jelkinsjames/chameleon-PCB/PCM1863/README.md

# PCM1863 ADC

The purpose of the ADC in the system is to take analog inputs from control voltages (5V) and convert them into readable I2S digital signals. The digital signals will be processed by the embedded board to be modified by [YASE](https://github.com/klavins/yase) (a synthesizer engine created by Eric Klavins).

The ADC creation has three steps:
1. [Creating the physical ADC board](https://github.com/jelkinsjames/chameleon-PCB/tree/main/PCM1863/board)
2. [Setting up the ADC board and embedded board](https://github.com/jelkinsjames/chameleon-PCB/tree/main/PCM1863/setup)
3. [Using the ADC with the embedded board](https://github.com/jelkinsjames/chameleon-PCB/tree/main/PCM1863/usage)

We will be using the PCM1863 chip by TI for our ADC. The [PCM1863](https://www.ti.com/product/PCM1863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) is an audio-controlled analog-to-digital (ADC) converter. The chip is 110dB 2-channel software controlled. The chip is made by Texas Instruments (TI), and its datasheet is available here: [PCM1863 Datasheet](https://www.ti.com/lit/ds/symlink/pcm1861-q1.pdf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). The chip is a TSSOP (DBT) 30 pin package. The chip is hardware and software controllable.

Drivers for the PCM 186x series are available [here](https://e2e.ti.com/support/audio-group/audio/f/audio-forum/773056/faq-linux-drivers-device-drivers-for-aic31xx-dac31xx-aic325x-aic320x-aic326x-aic321x). More driver information can be found on the [TI webpage](https://www.ti.com/product/PCM1863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) for the PCM1863.

The [Ti PCM186X Evaluation Board](https://www.ti.com/lit/ug/slau615/slau615.pdf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) has additional resources on how to design an example board. [PurePath Console 3 (PPC3)](https://www.ti.com/tool/PUREPATHCONSOLE) is a GUI for development of audio chips such as the PCM1863

Here is a block diagram of the chip we are using:

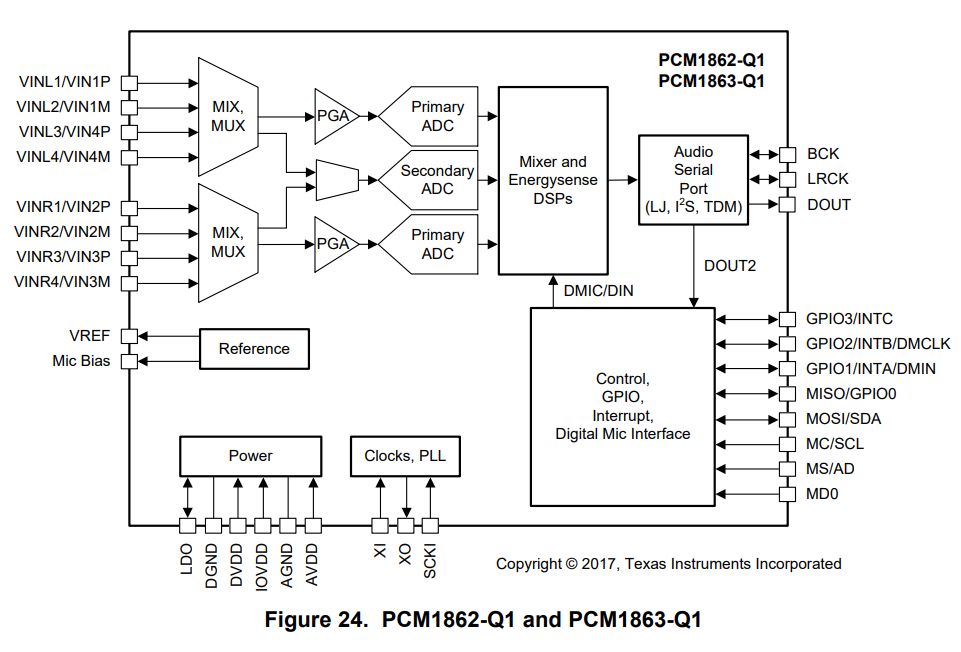
[picture p4: PCM1863/blockdiagram.png]


---
