jelkinsjames/chameleon-PCB/PCM1863/adc_3d.png

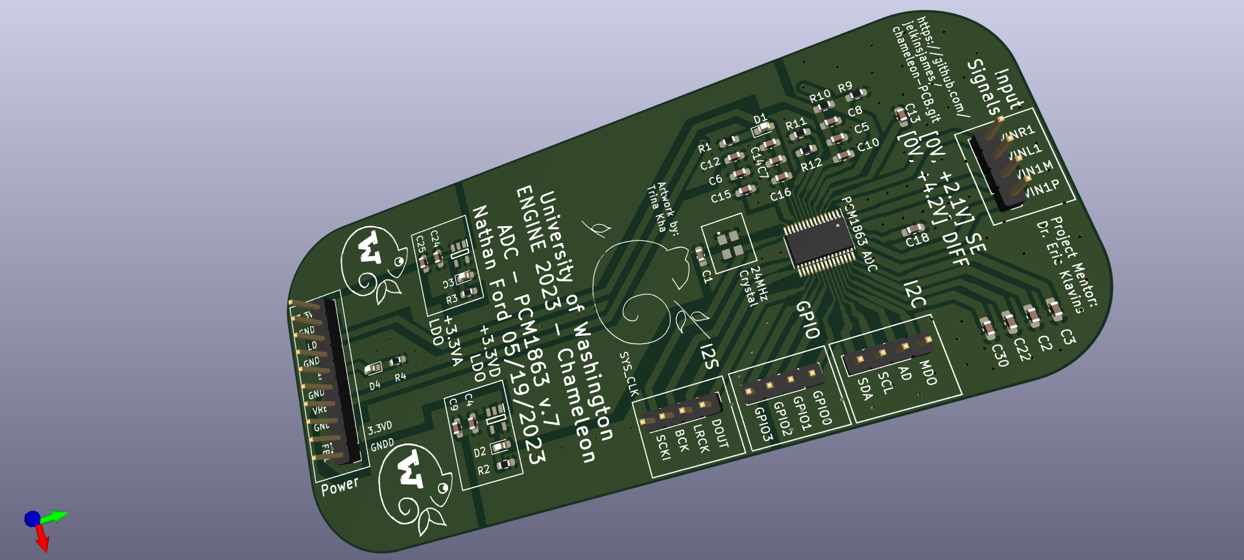
PCM1863/adc_3d.png
