jelkinsjames/chameleon-PCB/PCM1863/docs/assets/images/mastermodeex.png

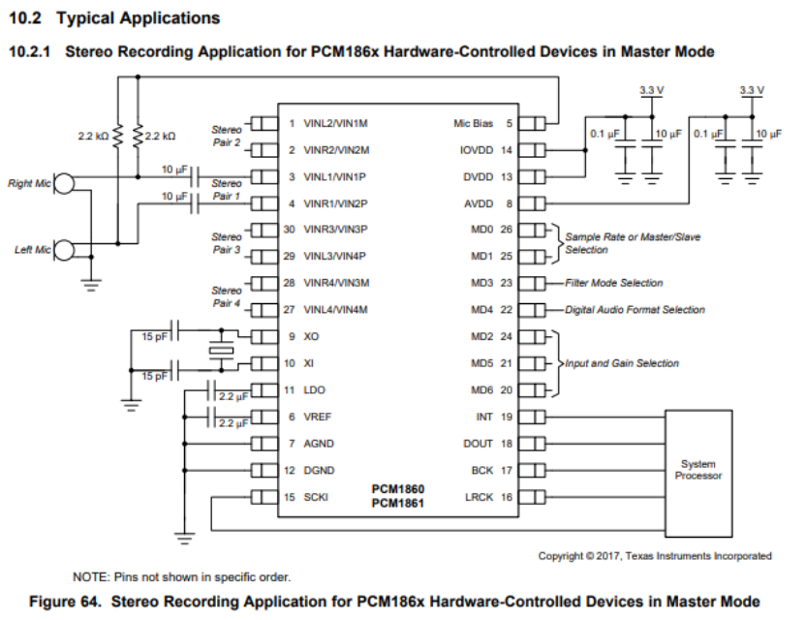
PCM1863/docs/assets/images/mastermodeex.png
