jelkinsjames/chameleon-PCB/PCM1863/docs/assets/images/timingmastermode.png

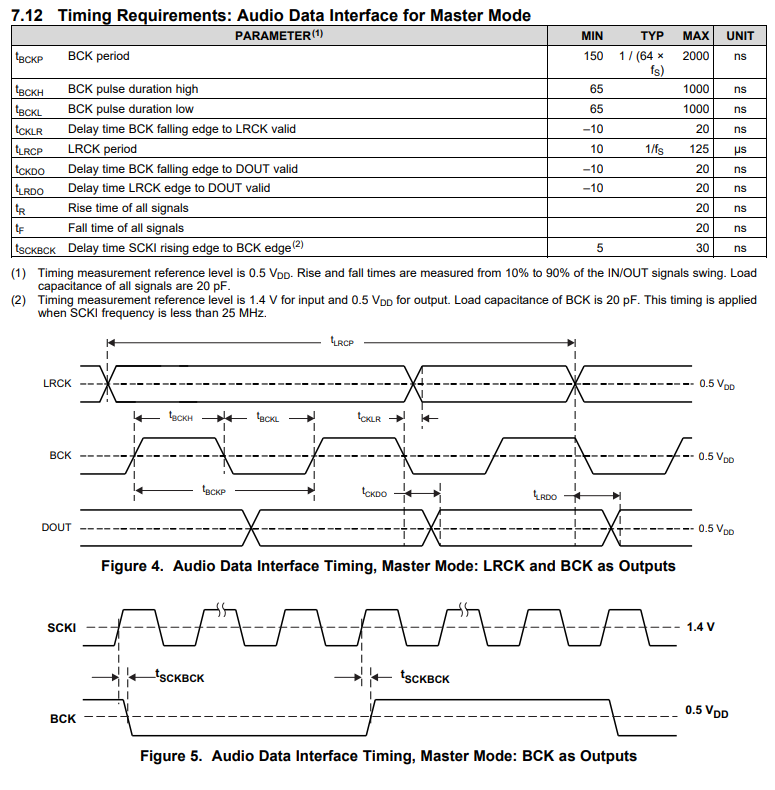
PCM1863/docs/assets/images/timingmastermode.png
