jelkinsjames/chameleon-PCB/STM32tut/manufacturing/STM32tut.csv

Source: | C:\Users\natha\OneDrive - UW\Fourth Year\WINTER\EE 497\KiCad\chameleon-PCB\STM32tut\STM32tut.kicad_sch
Date: | 2/15/2023 1:02:03 PM
Tool: | Eeschema (6.0.5)
Generator: | C:\Program Files\KiCad\6.0\bin\scripting\plugins/bom_csv_grouped_by_value_with_fp.py
Component Count: | 32
Ref | Qnty | Value | Cmp name | Footprint | Description | Vendor
C1, C2, | 2 | 22uF | C | Capacitor_SMD:C_0805_2012Metric_Pad1.18x1.45mm_HandSolder | Unpolarized capacitor
C3, | 1 | 10uF | C | Capacitor_SMD:C_0603_1608Metric_Pad1.08x0.95mm_HandSolder | Unpolarized capacitor
C4, C7, | 2 | 10pF | C | Capacitor_SMD:C_0402_1005Metric_Pad0.74x0.62mm_HandSolder | Unpolarized capacitor
C5, C6, C8, C9, C10, | 5 | 100nF | C | Capacitor_SMD:C_0402_1005Metric_Pad0.74x0.62mm_HandSolder | Unpolarized capacitor
C11, | 1 | 10nF | C | Capacitor_SMD:C_0402_1005Metric_Pad0.74x0.62mm_HandSolder | Unpolarized capacitor
C12, C13, | 2 | 1uF | C | Capacitor_SMD:C_0603_1608Metric_Pad1.08x0.95mm_HandSolder | Unpolarized capacitor
D1, | 1 | RED1.8 | LED | LED_SMD:LED_0603_1608Metric_Pad1.05x0.95mm_HandSolder | Light emitting diode
FB1, | 1 | 120R | FerriteBead | Inductor_SMD:L_0603_1608Metric_Pad1.05x0.95mm_HandSolder | Ferrite bead
H1, H2, H3, H4, | 4 | MountingHole_Pad | MountingHole_Pad | MountingHole:MountingHole_2.2mm_M2_Pad | Mounting Hole with connection
J1, J2, J3, | 3 | Conn_01x04_Male | Conn_01x04_Male | Connector_PinHeader_2.54mm:PinHeader_1x04_P2.54mm_Vertical | Generic connector, single row, 01x04, script generated (kicad-library-utils/schlib/autogen/connector/)
J4, | 1 | USB_B_Micro | USB_B_Micro | Connector_USB:USB_Micro-B_Wuerth_629105150521 | USB Micro Type B connector
R1, R2, R3, R5, | 4 | 1.5k | R | Resistor_SMD:R_0402_1005Metric_Pad0.72x0.64mm_HandSolder | Resistor
R4, | 1 | 10k | R | Resistor_SMD:R_0402_1005Metric_Pad0.72x0.64mm_HandSolder | Resistor
SW1, | 1 | SW_SPDT | SW_SPDT | Button_Switch_SMD:SW_SPDT_PCM12 | Switch, single pole double throw
U1, | 1 | AMS1117-3.3 | AMS1117-3.3 | Package_TO_SOT_SMD:SOT-223-3_TabPin2 | 1A Low Dropout regulator, positive, 3.3V fixed output, SOT-223
U2, | 1 | STM32F103C8T6 | STM32F103C8Tx | Package_QFP:LQFP-48_7x7mm_P0.5mm | ARM Cortex-M3 MCU, 64KB flash, 20KB RAM, 72MHz, 2-3.6V, 37 GPIO, LQFP-48
Y1, | 1 | 16MHz | Crystal_GND24 | Crystal:Crystal_SMD_3225-4Pin_3.2x2.5mm_HandSoldering | Four pin crystal, GND on pins 2 and 4
