jelkinsjames/chameleon-PCB/PCM5242/IC_ADS125H01IRHBT/IC_ADS125H01IRHBT.step

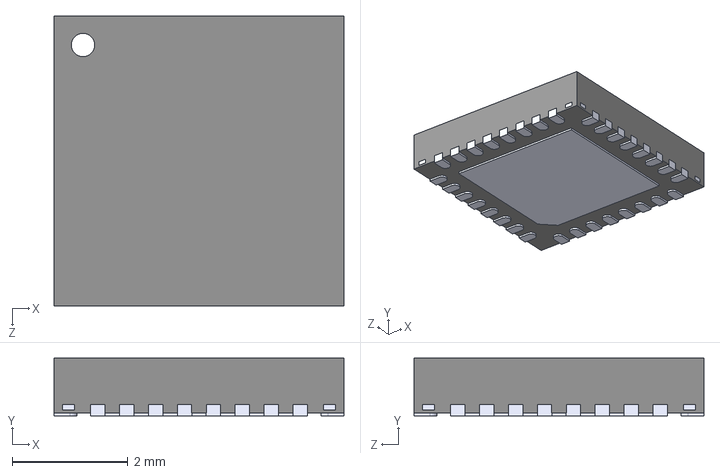
[picture p35: CAD file, 2023-04-08]
PCM5242/IC_ADS125H01IRHBT/IC_ADS125H01IRHBT.step
5.00 x 1.00 x 5.00 mm

STM32tut/629105150521 (rev1).stp
8.00 x 6.60 x 4.52 mm
629105150521_Housing
629105150521_Pin1 x 4
629105150521_Pin2
629105150521_Shielding2
629105150521_Shielding
