jelkinsjames/chameleon-PCB/PCM1863/adc_schematic.pdf

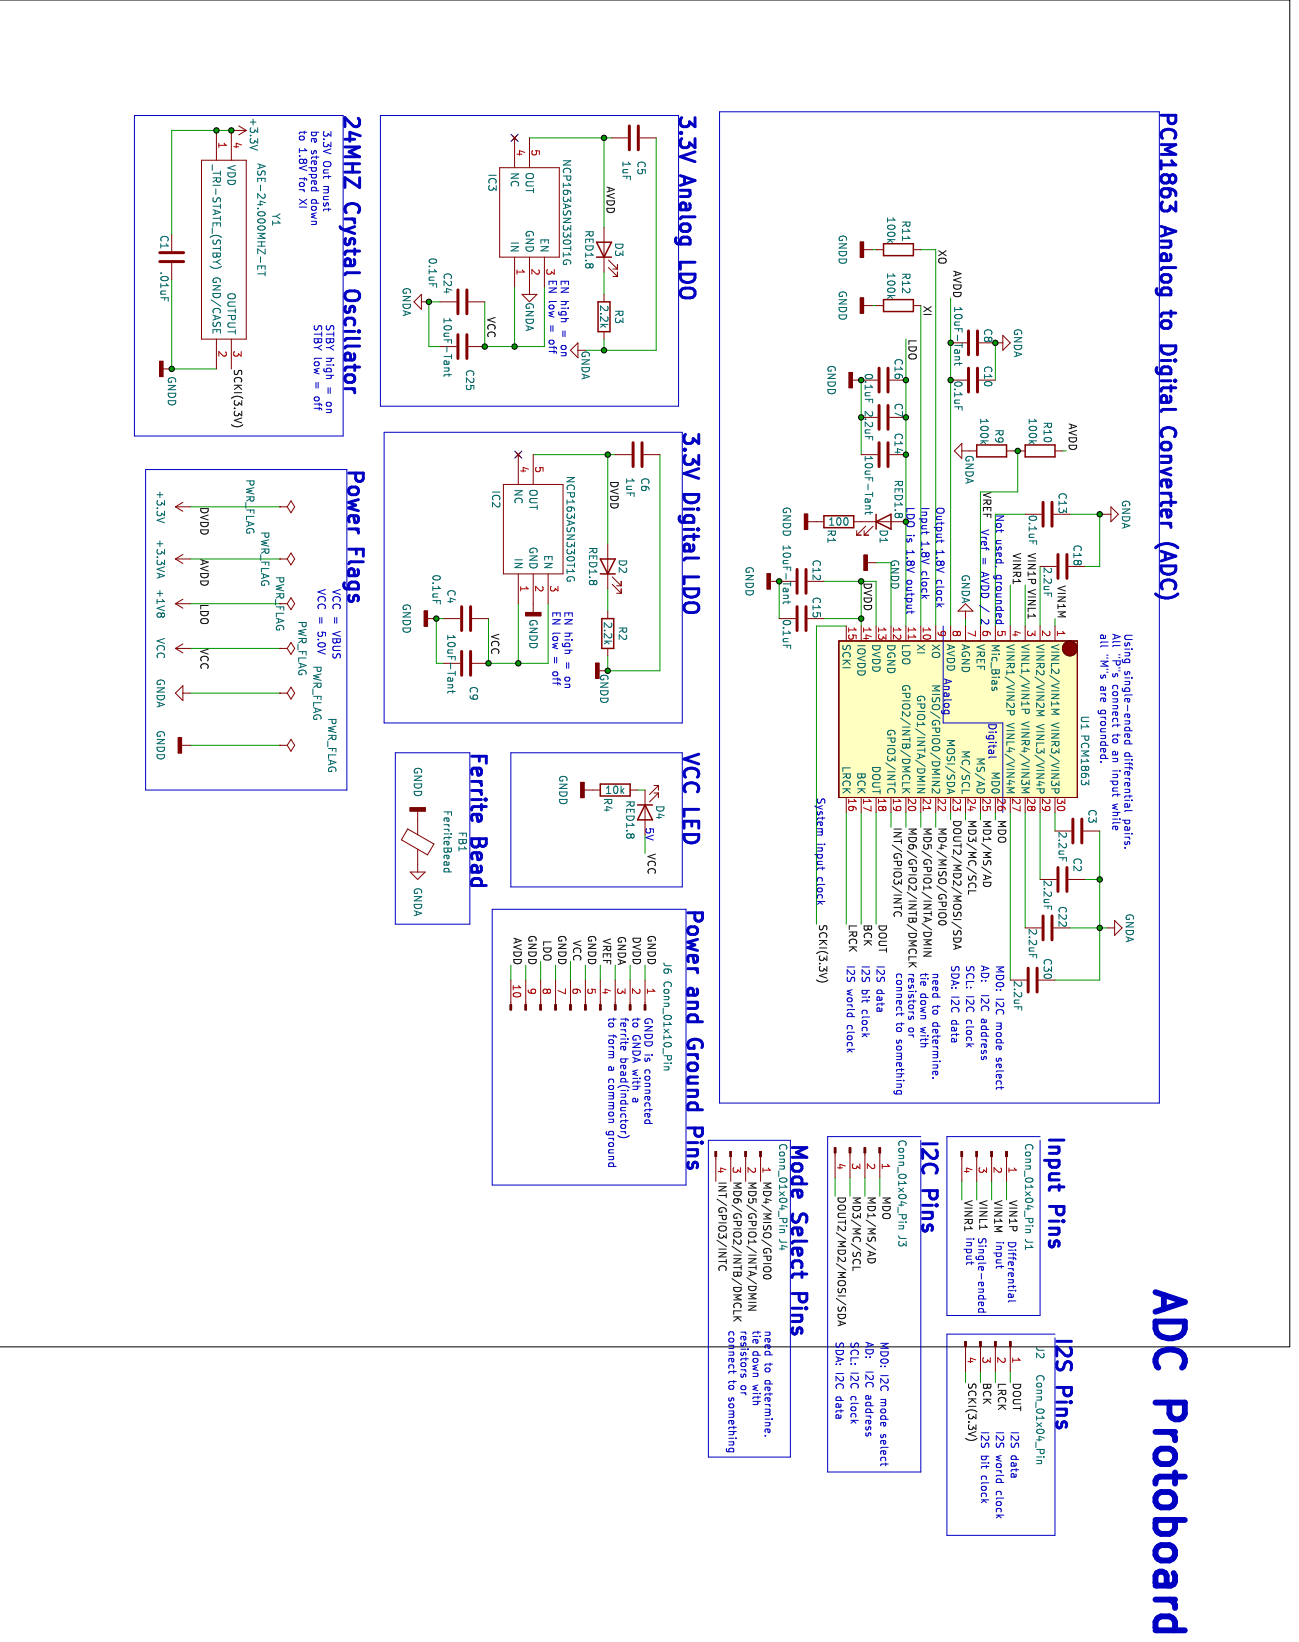
[picture p37: page 1]
