jelkinsjames/chameleon-PCB/PCM1863/adc_pcb.pdf

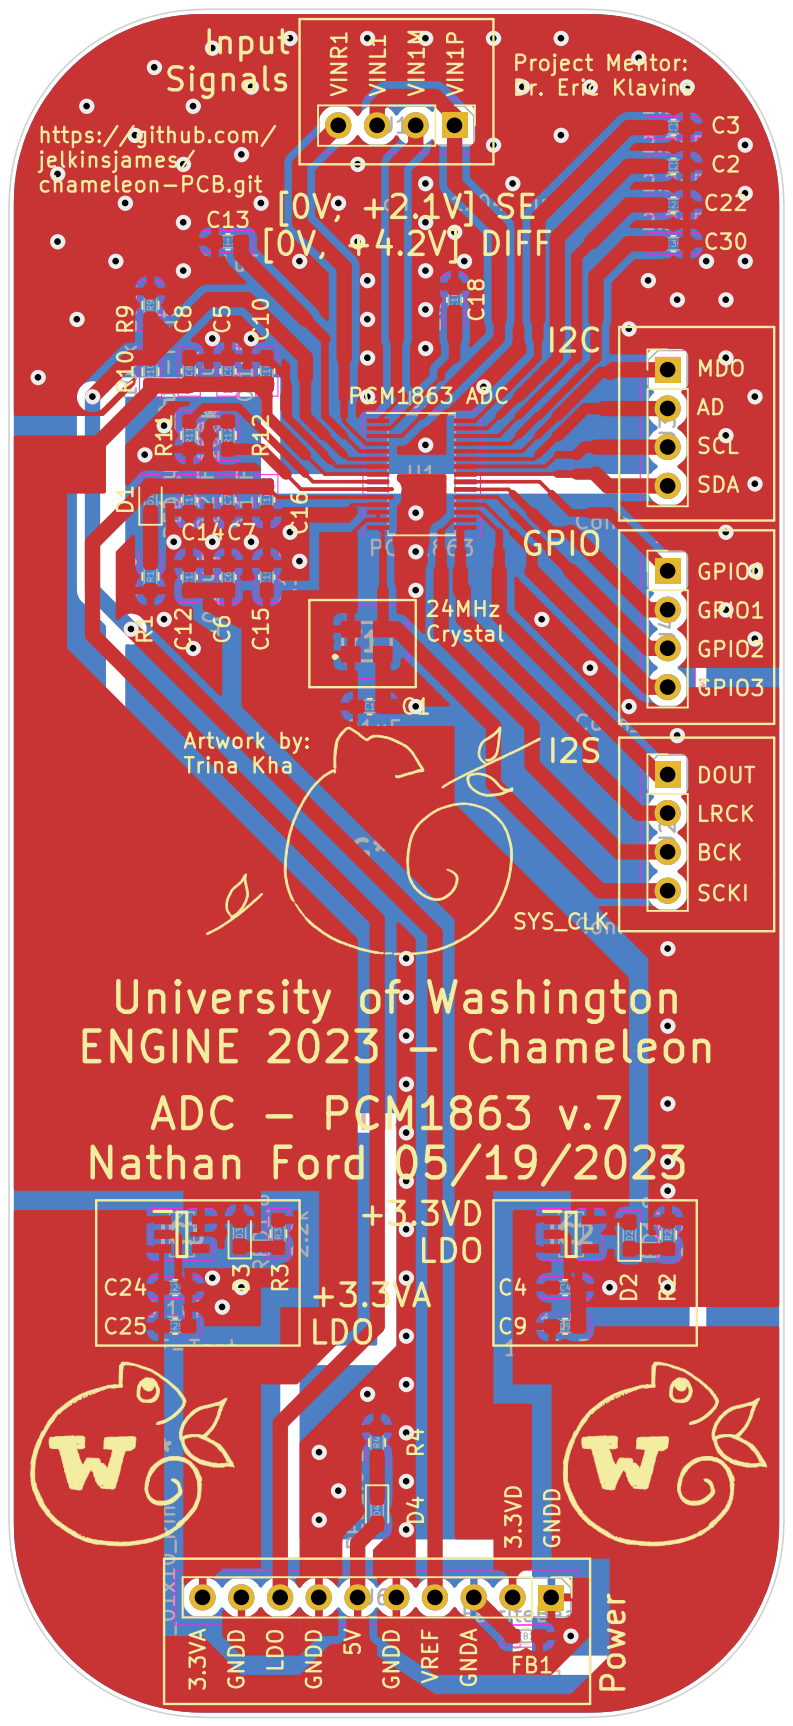
[picture p38: page 1]
