jelkinsjames/chameleon-PCB/IOBoard_ATSAMD21/IOBoard_ATSAMD21.kicad_pcb

## KiCad design IOBoard_ATSAMD21/IOBoard_ATSAMD21.kicad_pcb (2023-05-22)

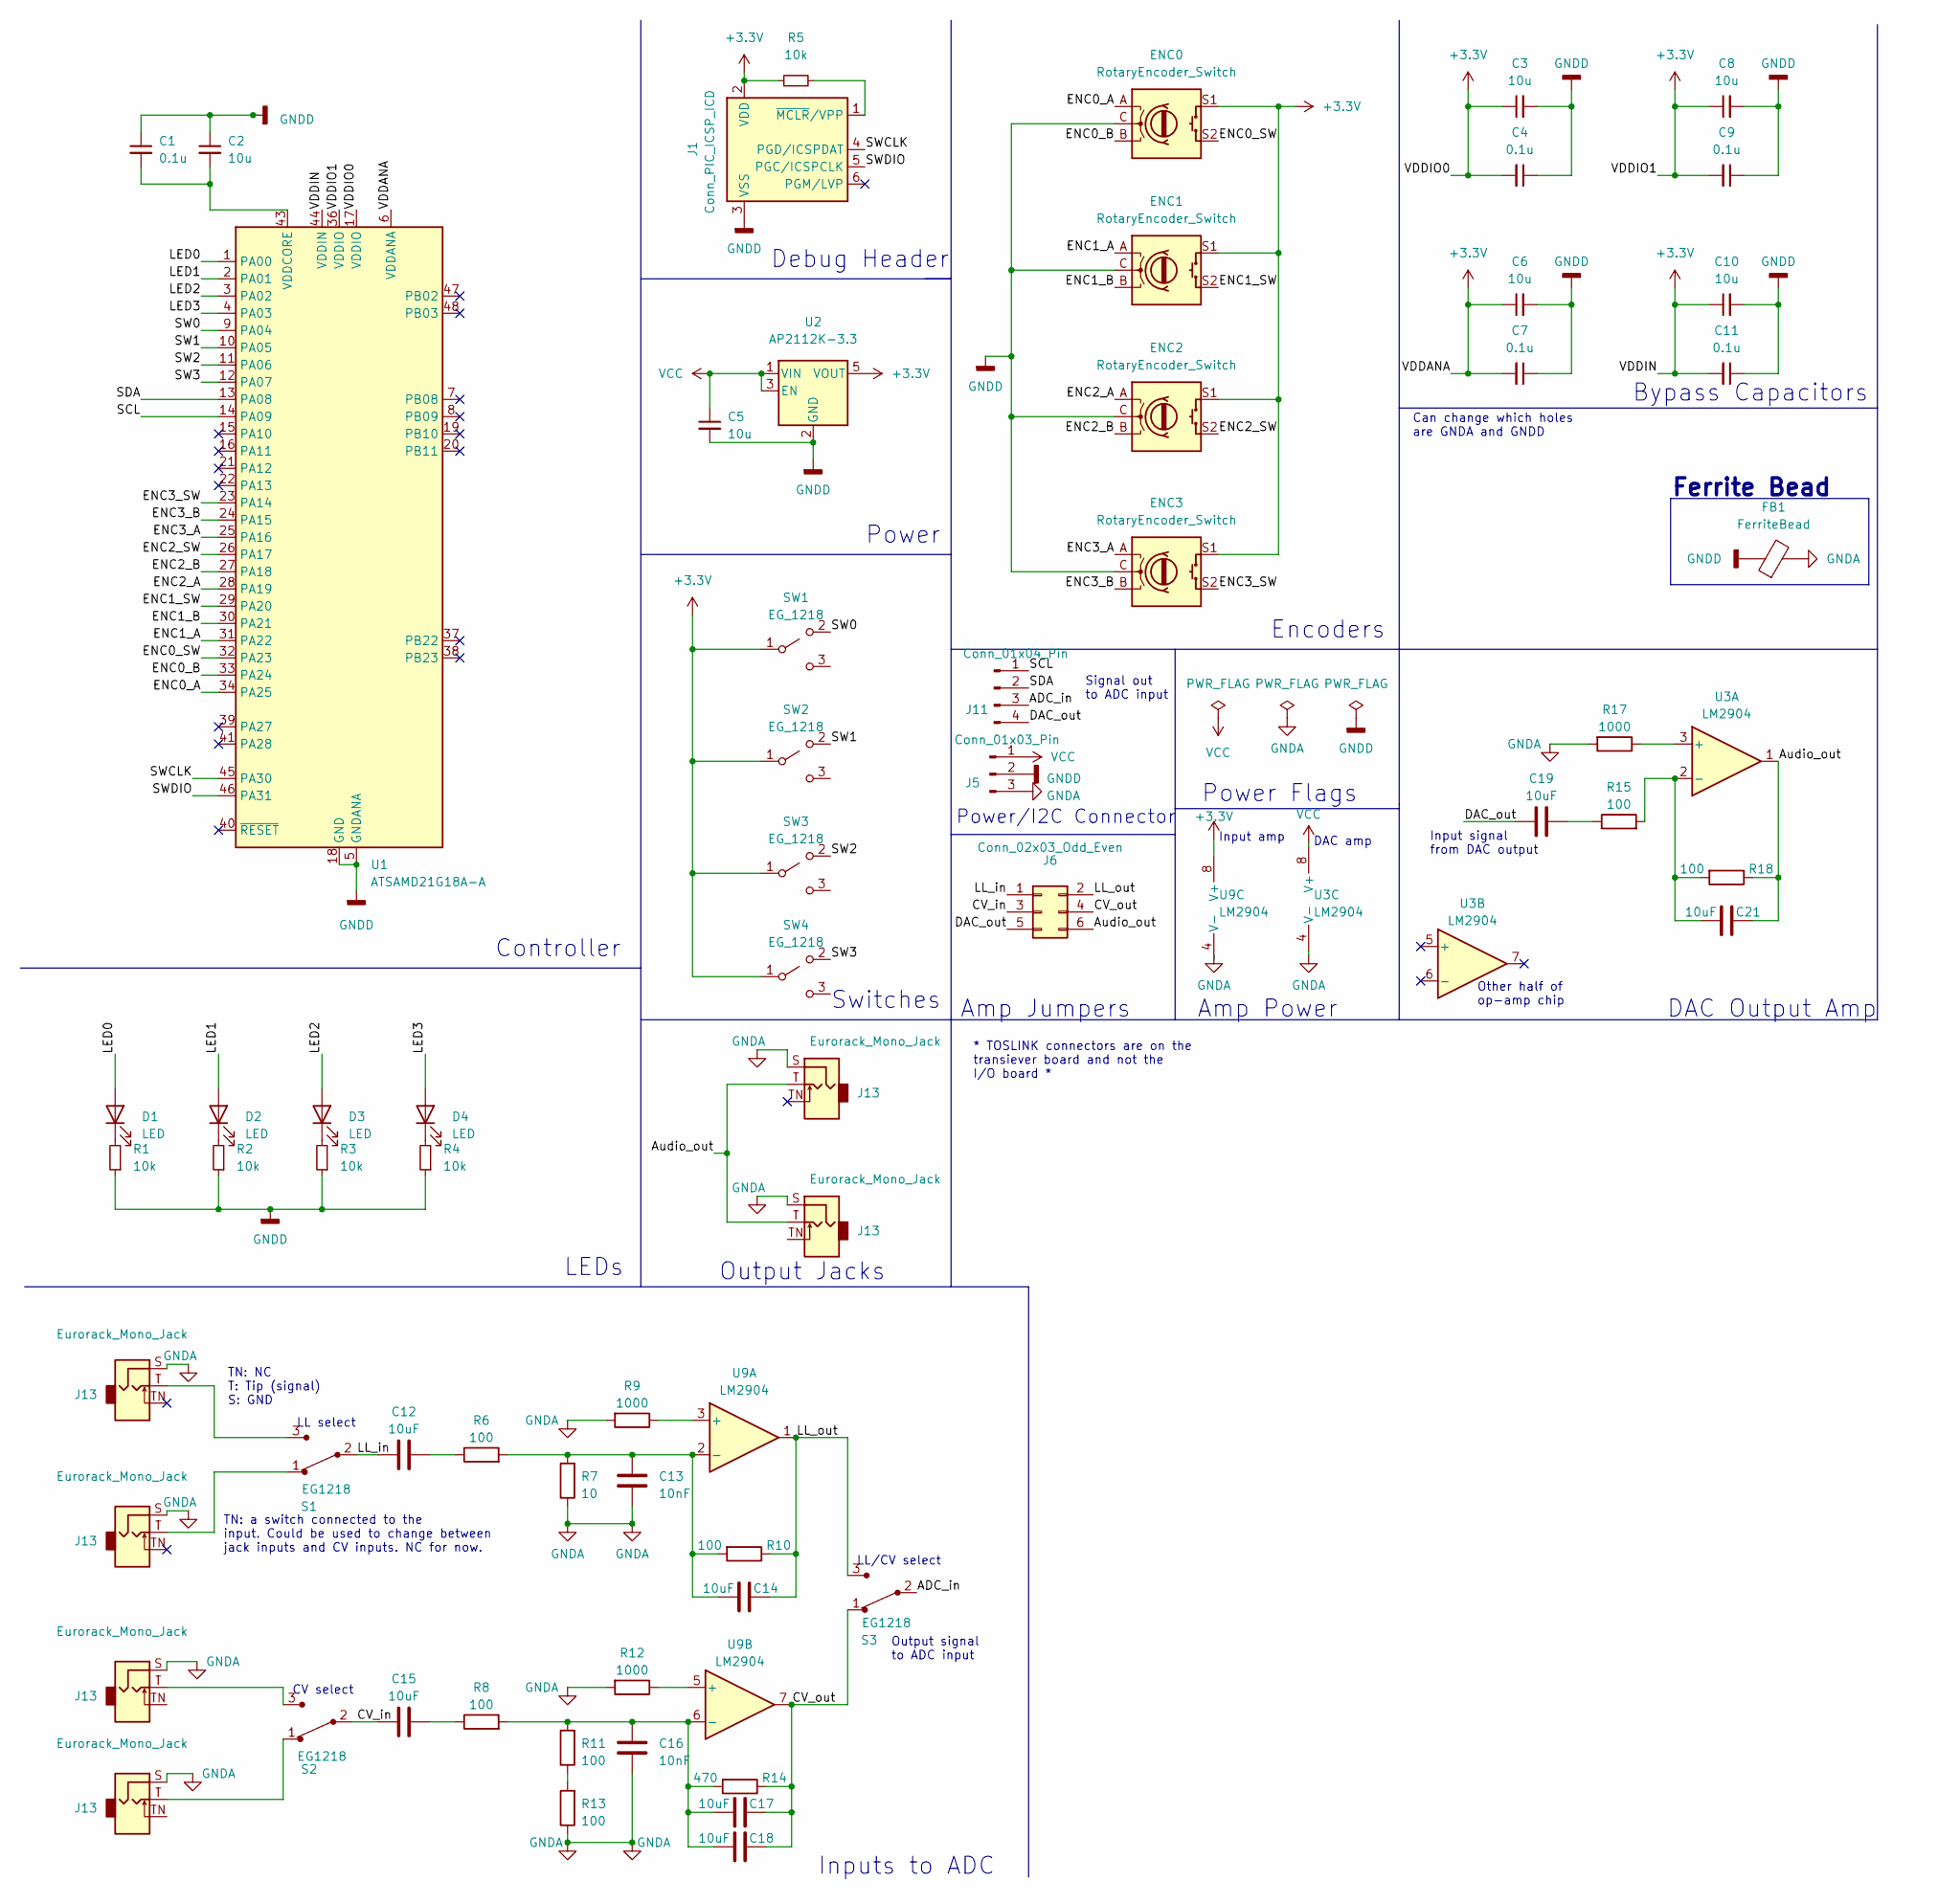
[picture p39: schematic IOBoard_ATSAMD21.kicad_sch, I/O Board]

Parts:
C1, C4, C7, C9, C11: 0.1u; C_0603_1608Metric
C2, C3, C5, C6, C8, C10: 10u; C_0603_1608Metric
C12, C14, C15, C17, C18, C19, C21: 10uF; C_0603_1608Metric
C13, C16: 10nF; C_0603_1608Metric
D1, D2, D3, D4: LED; LED_Rectangular_W5.0mm_H2.0mm
ENC0, ENC1, ENC2, ENC3: RotaryEncoder_Switch; PEC12R-3217F-S0024-ND
FB1: FerriteBead; L_0603_1608Metric_Pad1.05x0.95mm_HandSolder
J1: Conn_PIC_ICSP_ICD; PinHeader_1x06_P2.54mm_Vertical
J5: Conn_01x03_Pin; PinHeader_1x03_P2.54mm_Vertical
J6: Conn_02x03_Odd_Even; PinHeader_2x03_P2.54mm_Vertical
J11: Conn_01x04_Pin; PinHeader_1x04_P2.54mm_Vertical
J13: Eurorack_Mono_Jack; AudioJack_WQP518MA; MPN WQP-WQP518MA
R1, R2, R3, R4, R5: 10k; R_0603_1608Metric
R6, R8, R10, R11, R13, R15, R18: 100; R_0603_1608Metric
R7: 10; R_0603_1608Metric
R9, R12, R17: 1000; R_0603_1608Metric
R14: 470; R_0603_1608Metric
S1, S2, S3: EG1218; EG_1218; MPN EG1218; Digi-Key_PN EG1903-ND
SW1, SW2, SW3, SW4: EG_1218
U1: ATSAMD21G18A-A; TQFP-48_7x7mm_P0.5mm
U2: AP2112K-3.3; SOT-23-5
U3, U9: LM2904; SOIC-8_3.9x4.9mm_P1.27mm

Connections:
+3.3V: C3.1, C4.2, C6.1, C7.2, C8.1, C9.2, C10.1, C11.2, ENC0.S1, ENC1.S1, ENC2.S1, ENC3.S1, J1.2 (VDD), R5.1, SW1.1, SW2.1, SW3.1, SW4.1, U1.6 (VDDANA), U1.17 (VDDIO), U1.36 (VDDIO), U1.44 (VDDIN), U2.5 (VOUT), U9.8 (V+)
/ADC_in: J11.3, S3.2
/Audio_out: C21.1, J6.6, R18.1, U3.1; also elsewhere on the board
/CV_in: C15.1, J6.3, S2.2
/CV_out: C17.1, C18.1, J6.4, R14.1, S3.1, U9.7
/DAC_out: C19.1, J6.5, J11.4
/ENC0_A: ENC0.A, U1.34 (PA25)
/ENC0_B: ENC0.B, U1.33 (PA24)
/ENC0_SW: ENC0.S2, U1.32 (PA23)
/ENC1_A: ENC1.A, U1.31 (PA22)
/ENC1_B: ENC1.B, U1.30 (PA21)
/ENC1_SW: ENC1.S2, U1.29 (PA20)
/ENC2_A: ENC2.A, U1.28 (PA19)
/ENC2_B: ENC2.B, U1.27 (PA18)
/ENC2_SW: ENC2.S2, U1.26 (PA17)
/ENC3_A: ENC3.A, U1.25 (PA16)
/ENC3_B: ENC3.B, U1.24 (PA15)
/ENC3_SW: ENC3.S2, U1.23 (PA14)
/LED0: D1.2 (A), U1.1 (PA00)
/LED1: D2.2 (A), U1.2 (PA01)
/LED2: D3.2 (A), U1.3 (PA02)
/LED3: D4.2 (A), U1.4 (PA03)
/LL_in: C12.1, J6.1, S1.2
/LL_out: C14.1, J6.2, R10.1, S3.3, U9.1
/SCL: J11.1, U1.14 (PA09)
/SDA: J11.2, U1.13 (PA08)
/SW0: SW1.2, U1.9 (PA04)
/SW1: SW2.2, U1.10 (PA05)
/SW2: SW3.2, U1.11 (PA06)
/SW3: SW4.2, U1.12 (PA07)
/SWCLK: J1.4 (PGD/ICSPDAT), U1.45 (PA30)
/SWDIO: J1.5 (PGC/ICSPCLK), U1.46 (PA31)
GNDA: C13.1, C16.1, FB1.2, J5.3, R7.1, R9.2, R12.2, R13.1, R17.2, U3.4 (V-), U9.4 (V-); also elsewhere on the board
GNDD: C1.1, C2.1, C3.2, C4.1, C5.2, C6.2, C7.1, C8.2, C9.1, C10.2, C11.1, ENC0.C, ENC1.C, ENC2.C, ENC3.C, FB1.1, J1.3 (VSS), J5.2, R1.1, R2.1, R3.1, R4.1, U1.5 (GNDANA), U1.18 (GND), U1.35 (GND), U1.42 (GND), U2.2 (GND)
unnamed: C12.2, R6.1
unnamed: C15.2, R8.1
unnamed: C19.2, R15.1
unnamed: D1.1 (K), R1.2
unnamed: D2.1 (K), R2.2
unnamed: D3.1 (K), R3.2
unnamed: D4.1 (K), R4.2
unnamed: J1.1 (~MCLR/VPP), R5.2
unnamed 42: S1.3; also elsewhere on the board
unnamed 43: S1.1; also elsewhere on the board
unnamed 44: S2.3; also elsewhere on the board
unnamed 45: S2.1; also elsewhere on the board
unnamed: R11.1, R13.2
unnamed: C1.2, C2.2, U1.43 (VDDCORE)
unnamed: R17.1, U3.3 (+)
unnamed: C21.2, R15.2, R18.2, U3.2 (-)
unnamed: R9.1, U9.3 (+)
unnamed: C13.2, C14.2, R6.2, R7.2, R10.2, U9.2 (-)
unnamed: R12.1, U9.5 (+)
unnamed: C16.2, C17.2, C18.2, R8.2, R11.2, R14.2, U9.6 (-)
VCC: C5.1, J5.1, U2.1 (VIN), U2.3 (EN), U3.8 (V+)

Notes on the sheet:
LL/CV select
TN: NC T: Tip (signal) S: GND
Input signal from DAC output
Other half of op-amp chip
CV select
LEDs
DAC amp
DAC Output Amp
Debug Header
Encoders
Amp Jumpers
Output Jacks
Switches
Ferrite Bead
Power
Input amp
* TOSLINK connectors are on the transiever board and not the I/O board *
Amp Power
Inputs to ADC
Power/I2C Connector
Signal out to ADC input
TN: a switch connected to the input. Could be used to change between jack inputs and CV inputs. NC for now.
Controller
LL select
Bypass Capacitors
Can change which holes are GNDA and GNDD
Power Flags
Output signal to ADC input

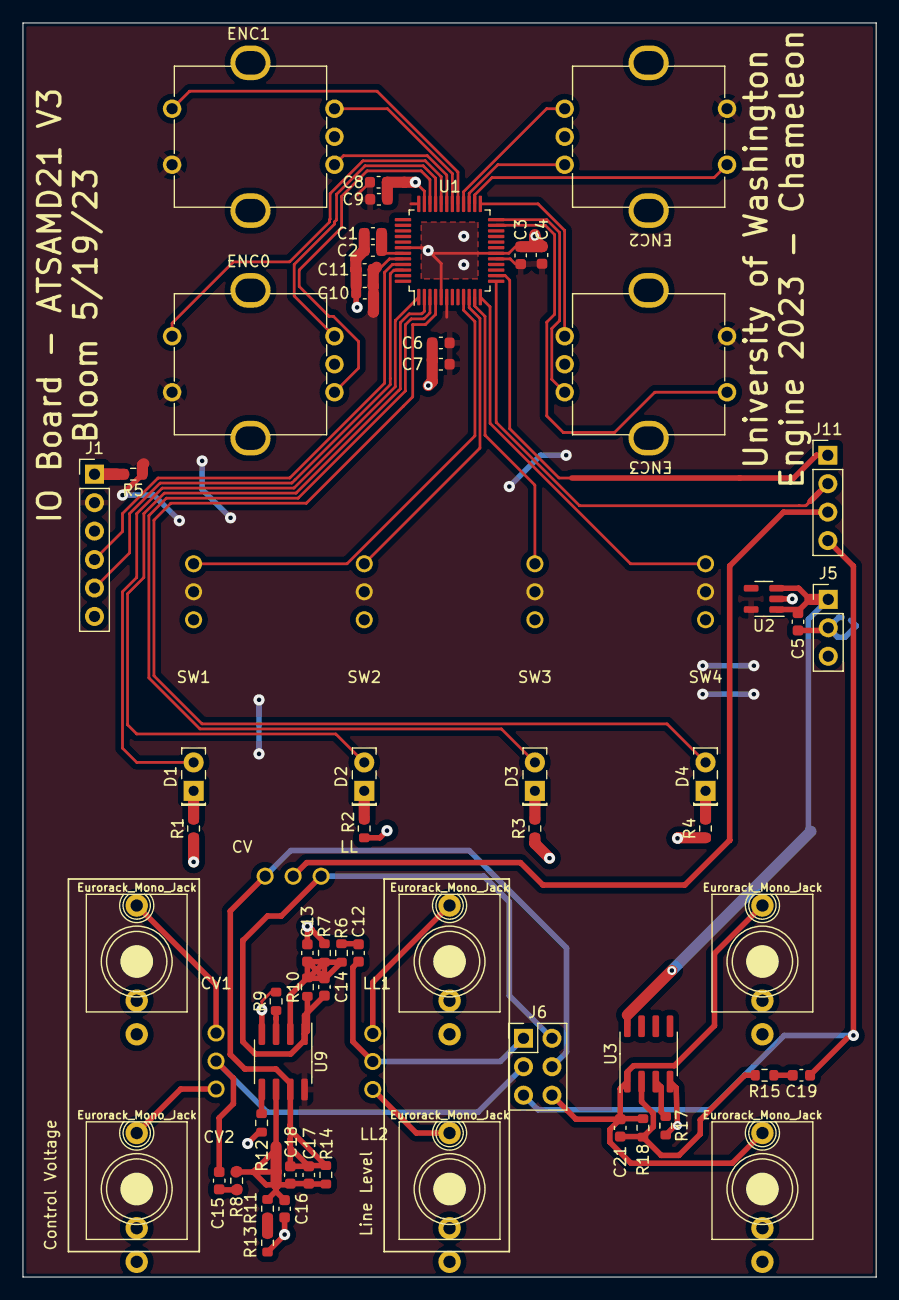
[picture p40: board IOBoard_ATSAMD21.kicad_pcb from above]

Board: 2 copper layers, 76.2 x 112.0 mm, 67 parts (1 on the bottom side), 55 nets.

Other parts of the board:
J2, J3, J4, J7, J8, J10: Eurorack_Mono_Jack; AudioJack_WQP518MA

Their connections:
/Audio_out: J2.T (Tip), J10.T (Tip); also elsewhere on the board
GNDA: J2.S (Sleeve), J3.S (Sleeve), J4.S (Sleeve), J7.S (Sleeve), J8.S (Sleeve), J10.S (Sleeve); also elsewhere on the board
unnamed 42: J3.T (Tip); also elsewhere on the board
unnamed 43: J4.T (Tip); also elsewhere on the board
unnamed 44: J7.T (Tip); also elsewhere on the board
unnamed 45: J8.T (Tip); also elsewhere on the board
