jelkinsjames/chameleon-PCB/PCM1863/PCM1863.kicad_pcb

## KiCad design PCM1863/PCM1863.kicad_pcb (2023-05-21)

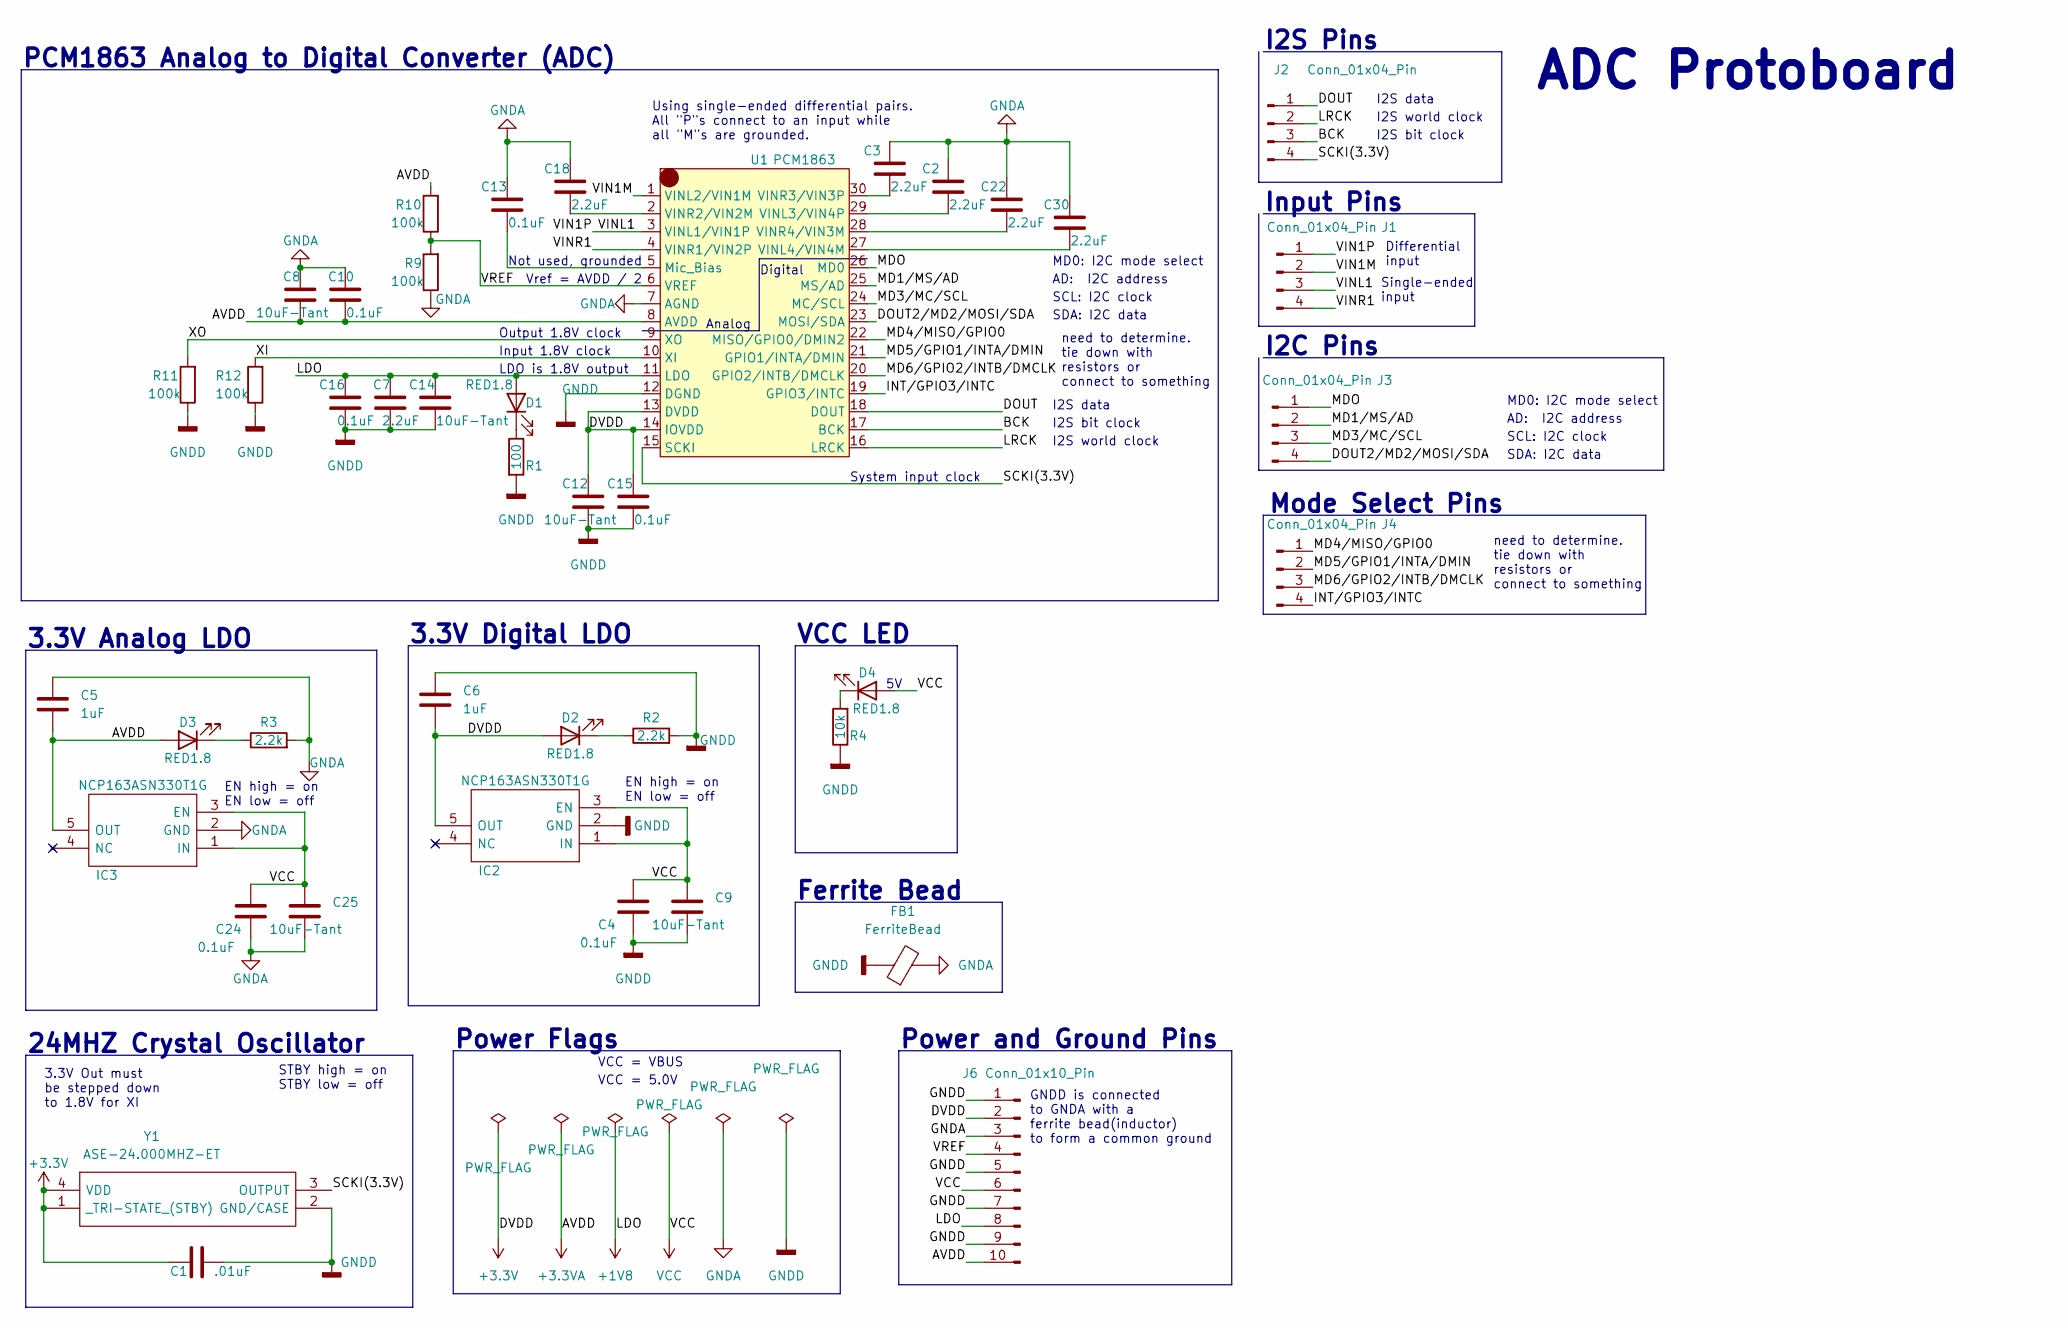
[picture p41: schematic PCM1863.kicad_sch, ADC Protoboard]

Parts:
C1: .01uF; C_0603_1608Metric_Pad1.08x0.95mm_HandSolder
C2, C3, C7, C18, C22, C30: 2.2uF; C_0603_1608Metric_Pad1.08x0.95mm_HandSolder
C4, C10, C13, C15, C16, C24: 0.1uF; C_0603_1608Metric_Pad1.08x0.95mm_HandSolder
C5, C6: 1uF; C_0603_1608Metric_Pad1.08x0.95mm_HandSolder
C8, C9, C12, C14, C25: 10uF-Tant; C_0603_1608Metric_Pad1.08x0.95mm_HandSolder
D1, D2, D3, D4: RED1.8; LED_0603_1608Metric_Pad1.05x0.95mm_HandSolder
FB1: FerriteBead; L_0603_1608Metric_Pad1.05x0.95mm_HandSolder
IC2, IC3: NCP163ASN330T1G; SOT95P280X145-5N; Manufacturer_Part_Number NCP163ASN330T1G; Mouser Part Number 863-NCP163ASN330T1G
J1, J2, J3, J4: Conn_01x04_Pin; PinHeader_1x04_P2.54mm_Vertical
J6: Conn_01x10_Pin; PinHeader_1x10_P2.54mm_Vertical
R1: 100; R_0603_1608Metric_Pad0.98x0.95mm_HandSolder
R2, R3: 2.2k; R_0603_1608Metric_Pad0.98x0.95mm_HandSolder
R4: 10k; R_0603_1608Metric_Pad0.98x0.95mm_HandSolder
R9, R10, R11, R12: 100k; R_0603_1608Metric_Pad0.98x0.95mm_HandSolder
U1: PCM1863; TSSOP-30_4.4x7.8mm_P0.5mm
Y1: ASE-24.000MHZ-ET; ASE24000MHZET; Manufacturer_Part_Number ASE-24.000MHZ-ET; Mouser Part Number 815-ASE24.000MHZET

Connections:
+1V8: C7.1, C14.1, C16.1, D1.2 (A), J6.8, U1.11 (LDO)
+3.3VA: C5.2, C8.2, C10.2, D3.2 (A), IC3.5 (OUT), J6.10, R10.2, U1.8 (AVDD)
+3V3: C1.1, C6.2, C12.1, C15.1, D2.2 (A), IC2.5 (OUT), J6.2, U1.13 (DVDD), U1.14 (IOVDD), Y1.1 (_TRI-STATE_(STBY)), Y1.4 (VDD)
/BCK: J2.3, U1.17 (BCK)
/DOUT: J2.1, U1.18 (DOUT)
/DOUT2/MD2/MOSI/SDA: J3.4, U1.23 (MOSI/SDA)
/INT/GPIO3/INTC: J4.4, U1.19 (GPIO3/INTC)
/LRCK: J2.2, U1.16 (LRCK)
/MD1/MS/AD: J3.2, U1.25 (MS/AD)
/MD3/MC/SCL: J3.3, U1.24 (MC/SCL)
/MD4/MISO/GPIO0: J4.1, U1.22 (MISO/GPIO0/DMIN2)
/MD5/GPIO1/INTA/DMIN: J4.2, U1.21 (GPIO1/INTA/DMIN)
/MD6/GPIO2/INTB/DMCLK: J4.3, U1.20 (GPIO2/INTB/DMCLK)
/MDO: J3.1, U1.26 (MD0)
/SCKI(3.3V): J2.4, U1.15 (SCKI), Y1.3 (OUTPUT)
/VIN1M: J1.2, U1.1 (VINL2/VIN1M)
/VIN1P: J1.1, J1.3, U1.3 (VINL1/VIN1P)
/VINR1: J1.4, U1.4 (VINR1/VIN2P)
/VREF: J6.4, R9.2, R10.1, U1.6 (VREF)
/XI: R12.2, U1.10 (XI)
/XO: R11.2, U1.9 (XO)
GNDA: C2.1, C3.1, C5.1, C8.1, C10.1, C13.1, C18.1, C22.1, C24.2, C25.2, C30.1, FB1.2, IC3.2 (GND), J6.3, R3.2, R9.1, U1.7 (AGND)
GNDD: C1.2, C4.2, C6.1, C7.2, C9.2, C12.2, C14.2, C15.2, C16.2, FB1.1, IC2.2 (GND), J6.1, J6.5, J6.7, J6.9, R1.2, R2.2, R4.1, R11.1, R12.1, U1.12 (DGND), Y1.2 (GND/CASE)
unnamed: D1.1 (K), R1.1
unnamed: D2.1 (K), R2.1
unnamed: D3.1 (K), R3.1
unnamed: D4.1 (K), R4.2
unnamed: C13.2, U1.5 (Mic_Bias)
unnamed: C2.2, U1.29 (VINL3/VIN4P)
unnamed: C30.2, U1.27 (VINL4/VIN4M)
unnamed: C18.2, U1.2 (VINR2/VIN2M)
unnamed: C3.2, U1.30 (VINR3/VIN3P)
unnamed: C22.2, U1.28 (VINR4/VIN3M)
VCC: C4.1, C9.1, C24.1, C25.1, D4.2 (A), IC2.1 (IN), IC2.3 (EN), IC3.1 (IN), IC3.3 (EN), J6.6

Notes on the sheet:
Digital
I2S world clock
Output 1.8V clock
Vref = AVDD / 2
I2S data
MD0: I2C mode select
System input clock
need to determine. tie down with resistors or connect to something
I2C Pins
Power Flags
STBY high = on STBY low = off
SCL: I2C clock
I2S Pins
LDO is 1.8V output
GNDD is connected to GNDA with a ferrite bead(inductor) to form a common ground
I2S bit clock
EN high = on EN low = off
PCM1863 Analog to Digital Converter (ADC)
VCC LED
ADC Protoboard
SDA: I2C data
3.3V Analog LDO
3.3V Out must be stepped down to 1.8V for XI
Input 1.8V clock
3.3V Digital LDO
Single-ended input
Not used, grounded
VCC = VBUS
VCC = 5.0V
Ferrite Bead
AD: I2C address
Mode Select Pins
Input Pins
Power and Ground Pins
Differential input
24MHZ Crystal Oscillator
Analog
Using single-ended differential pairs. All "P"s connect to an input while all "M"s are grounded.

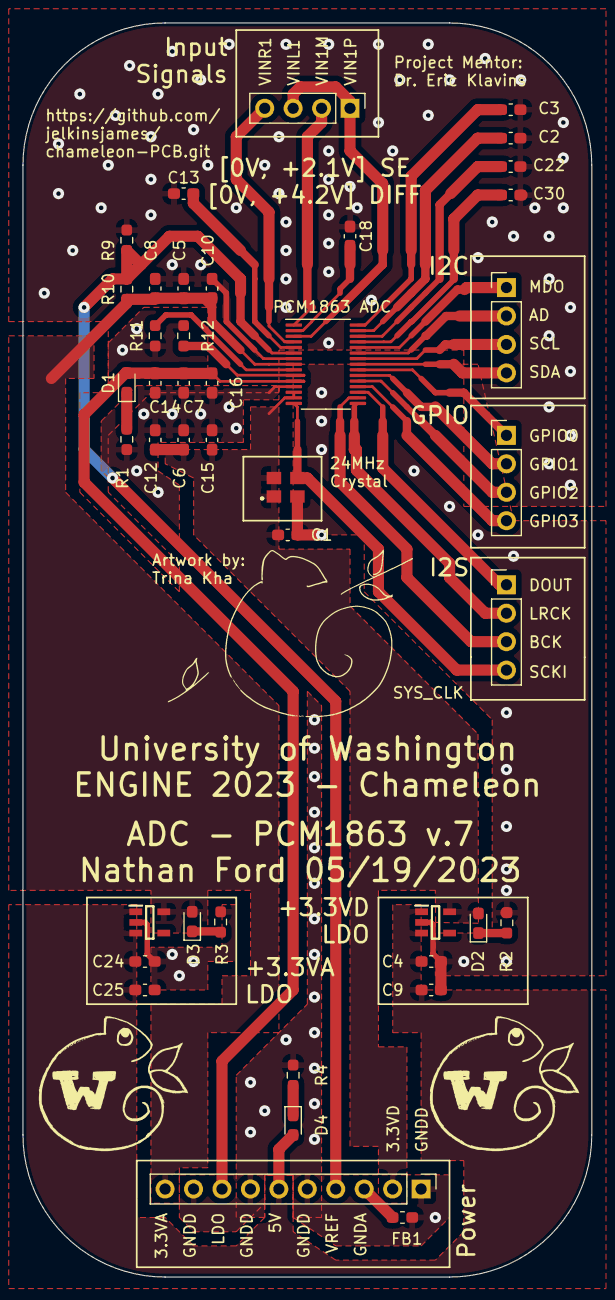
[picture p42: board PCM1863.kicad_pcb from above]

Board: 2 copper layers, 50.8 x 112.0 mm, 42 parts (0 on the bottom side), 34 nets.
