jelkinsjames/chameleon-PCB/PCM5242/restored/PCM5242.kicad_pcb

## KiCad design PCM5242/restored/PCM5242.kicad_pcb (2023-04-27)

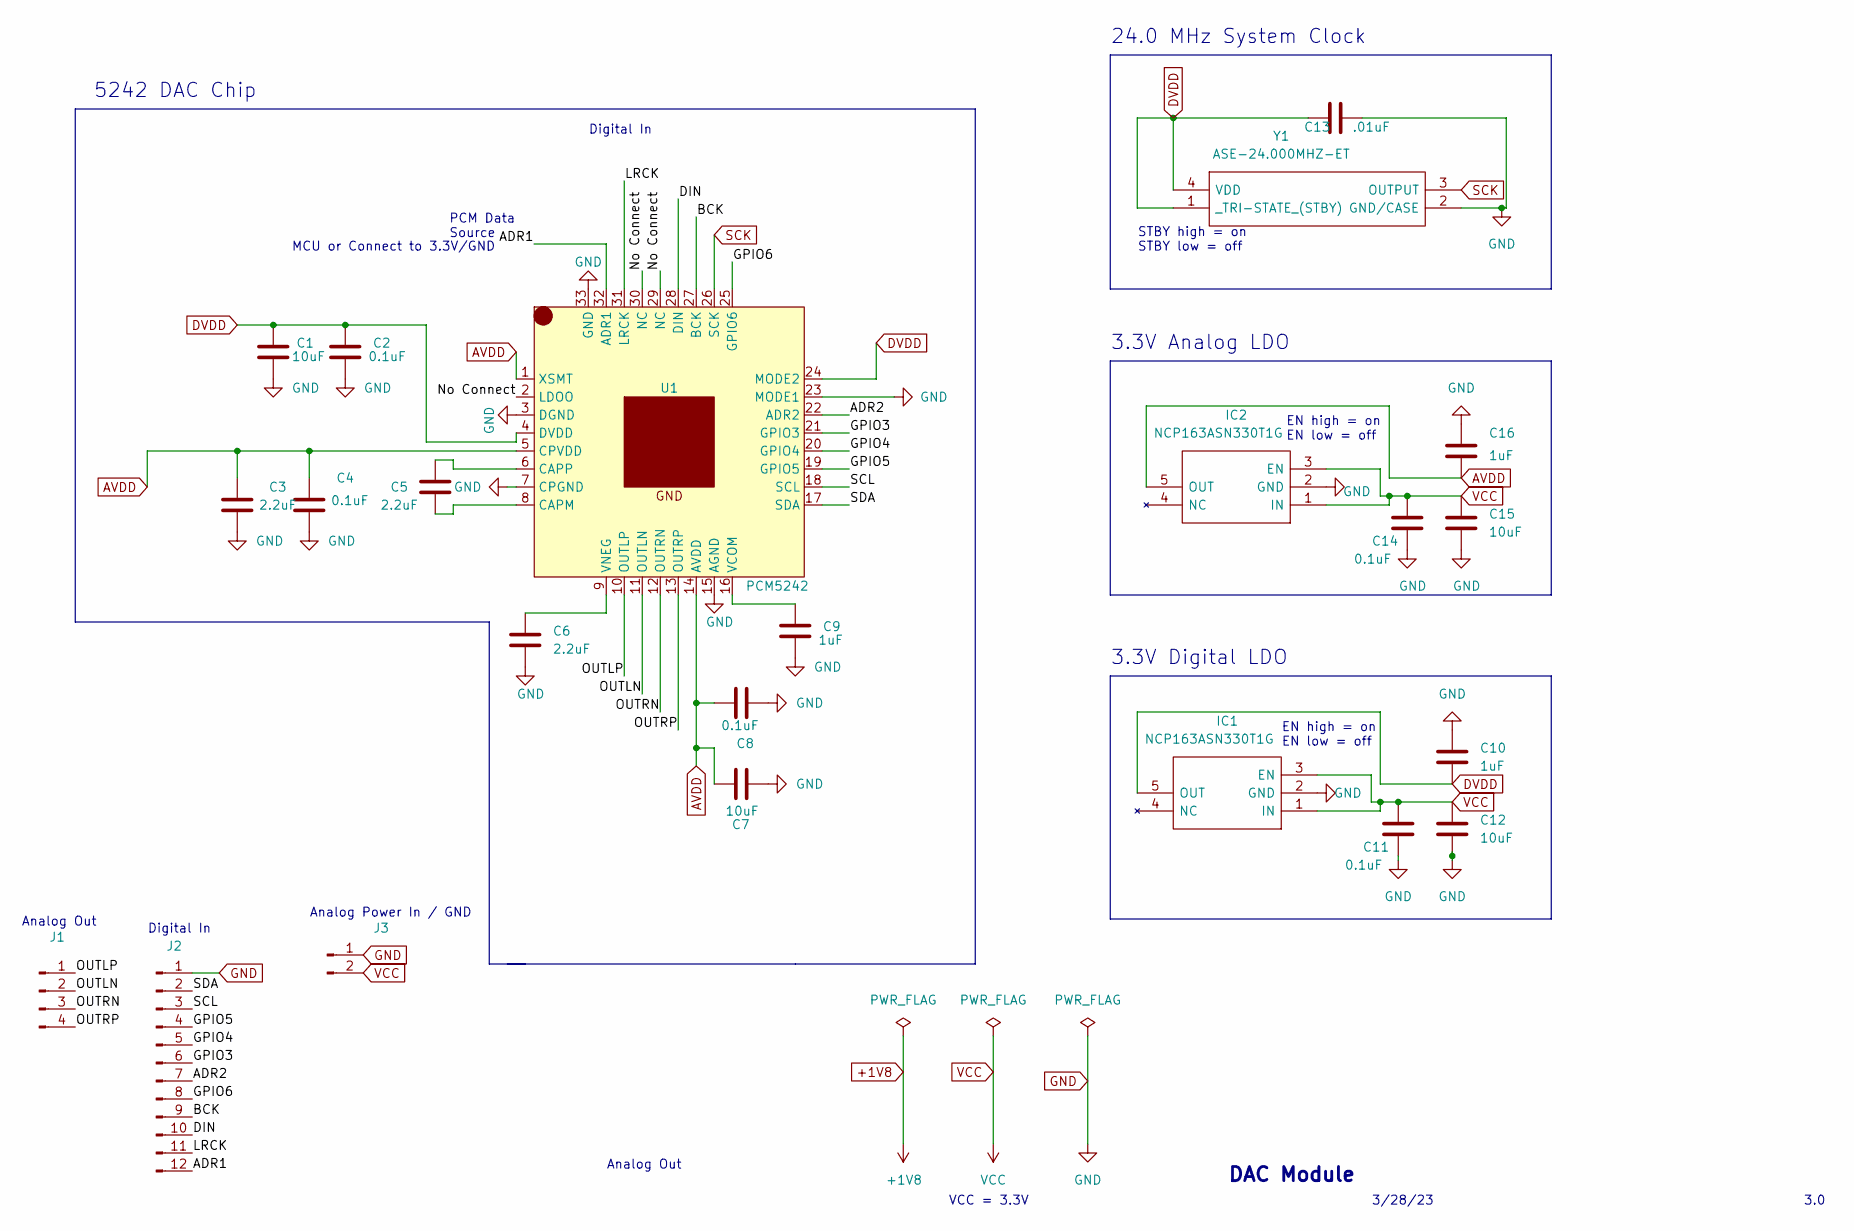
[picture p43: schematic PCM5242.kicad_sch]

Parts:
C1, C7, C12, C15: 10uF; C_0603_1608Metric_Pad1.08x0.95mm_HandSolder
C2, C4, C8, C11, C14: 0.1uF; C_0603_1608Metric_Pad1.08x0.95mm_HandSolder
C3, C5, C6: 2.2uF; C_0603_1608Metric_Pad1.08x0.95mm_HandSolder
C9, C10, C16: 1uF; C_0603_1608Metric_Pad1.08x0.95mm_HandSolder
C13: .01uF; C_0603_1608Metric_Pad1.08x0.95mm_HandSolder
IC1, IC2: NCP163ASN330T1G; SOT95P280X145-5N; Manufacturer_Part_Number NCP163ASN330T1G; Mouser Part Number 863-NCP163ASN330T1G
J1: Conn_01x04_Male; PinHeader_1x04_P2.54mm_Vertical
J2: Conn_01x12_Male; PinHeader_1x12_P2.54mm_Vertical
J3: d; PinHeader_1x02_P2.54mm_Vertical
U1: PCM5242; HVQFN-32-1EP_5x5mm_P0.5mm_EP3.1x3.1mm
Y1: ASE-24.000MHZ-ET; ASE24000MHZET; Manufacturer_Part_Number ASE-24.000MHZ-ET; Mouser Part Number 815-ASE24.000MHZET

Connections:
/ADR1: J2.12, U1.32 (ADR1)
/ADR2: J2.7, U1.22 (ADR2)
/BCK: J2.9, U1.27 (BCK)
/DIN: J2.10, U1.28 (DIN)
/GPIO3: J2.6, U1.21 (GPIO3)
/GPIO4: J2.5, U1.20 (GPIO4)
/GPIO5: J2.4, U1.19 (GPIO5)
/GPIO6: J2.8, U1.25 (GPIO6)
/LRCK: J2.11, U1.31 (LRCK)
/No Connect: U1.2 (LDOO), U1.29 (NC), U1.30 (NC)
/OUTLN: J1.2, U1.11 (OUTLN)
/OUTLP: J1.1, U1.10 (OUTLP)
/OUTRN: J1.3, U1.12 (OUTRN)
/OUTRP: J1.4, U1.13 (OUTRP)
/SCL: J2.3, U1.18 (SCL)
/SDA: J2.2, U1.17 (SDA)
AVDD: C3.1, C4.1, C7.1, C8.1, C16.2, IC2.5 (OUT), U1.1 (XSMT), U1.5 (CPVDD), U1.14 (AVDD)
DVDD: C1.2, C2.1, C10.2, C13.1, IC1.5 (OUT), U1.4 (DVDD), U1.24 (MODE2), Y1.1 (_TRI-STATE_(STBY)), Y1.4 (VDD)
GND: C1.1, C2.2, C3.2, C4.2, C6.2, C7.2, C8.2, C9.2, C10.1, C11.2, C12.2, C13.2, C14.2, C15.2, C16.1, IC1.2 (GND), IC2.2 (GND), J2.1, J3.1, U1.3 (DGND), U1.7 (CPGND), U1.15 (AGND), U1.23 (MODE1), U1.33 (GND), Y1.2 (GND/CASE)
unnamed: C5.1, U1.6 (CAPP)
unnamed: C5.2, U1.8 (CAPM)
unnamed: C6.1, U1.9 (VNEG)
unnamed: C9.1, U1.16 (VCOM)
SCK: U1.26 (SCK), Y1.3 (OUTPUT)
VCC: C11.1, C12.1, C14.1, C15.1, IC1.1 (IN), IC1.3 (EN), IC2.1 (IN), IC2.3 (EN), J3.2

Notes on the sheet:
Analog Out
Digital In
EN high = on EN low = off
3.0
Analog Power In / GND
3.3V Analog LDO
MCU or Connect to 3.3V/GND
24.0 MHz System Clock
STBY high = on STBY low = off
PCM Data Source
DAC Module
VCC = 3.3V
3.3V Digital LDO
Analog Out
Digital In
5242 DAC Chip
3/28/23

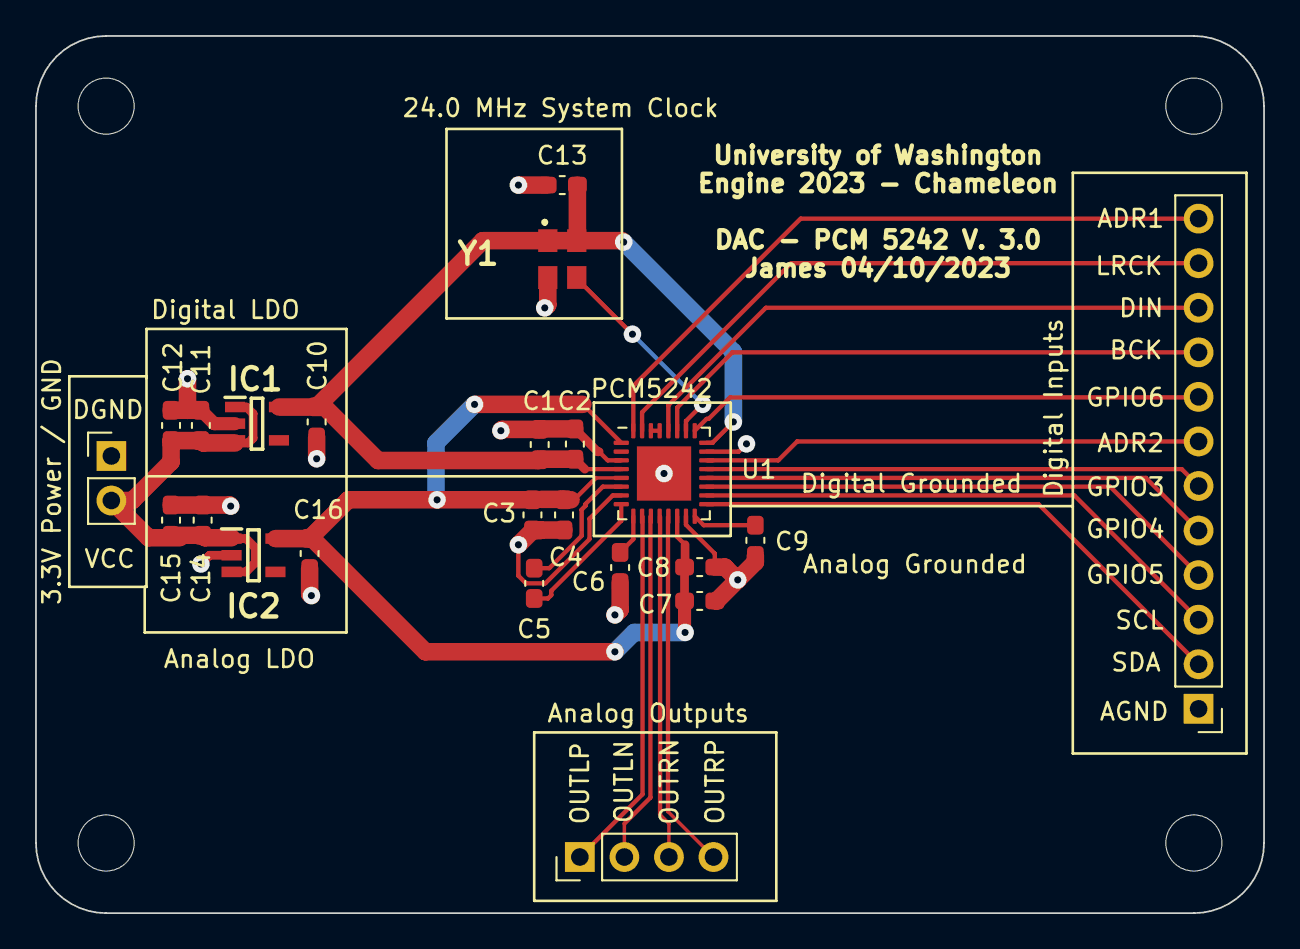
[picture p44: board PCM5242.kicad_pcb from above]

Board: 2 copper layers, 70.0 x 50.0 mm, 23 parts (0 on the bottom side), 25 nets.
