jelkinsjames/chameleon-PCB/DIX/Transmitter.kicad_pcb

## KiCad design DIX/Transmitter.kicad_pcb (2023-04-03)

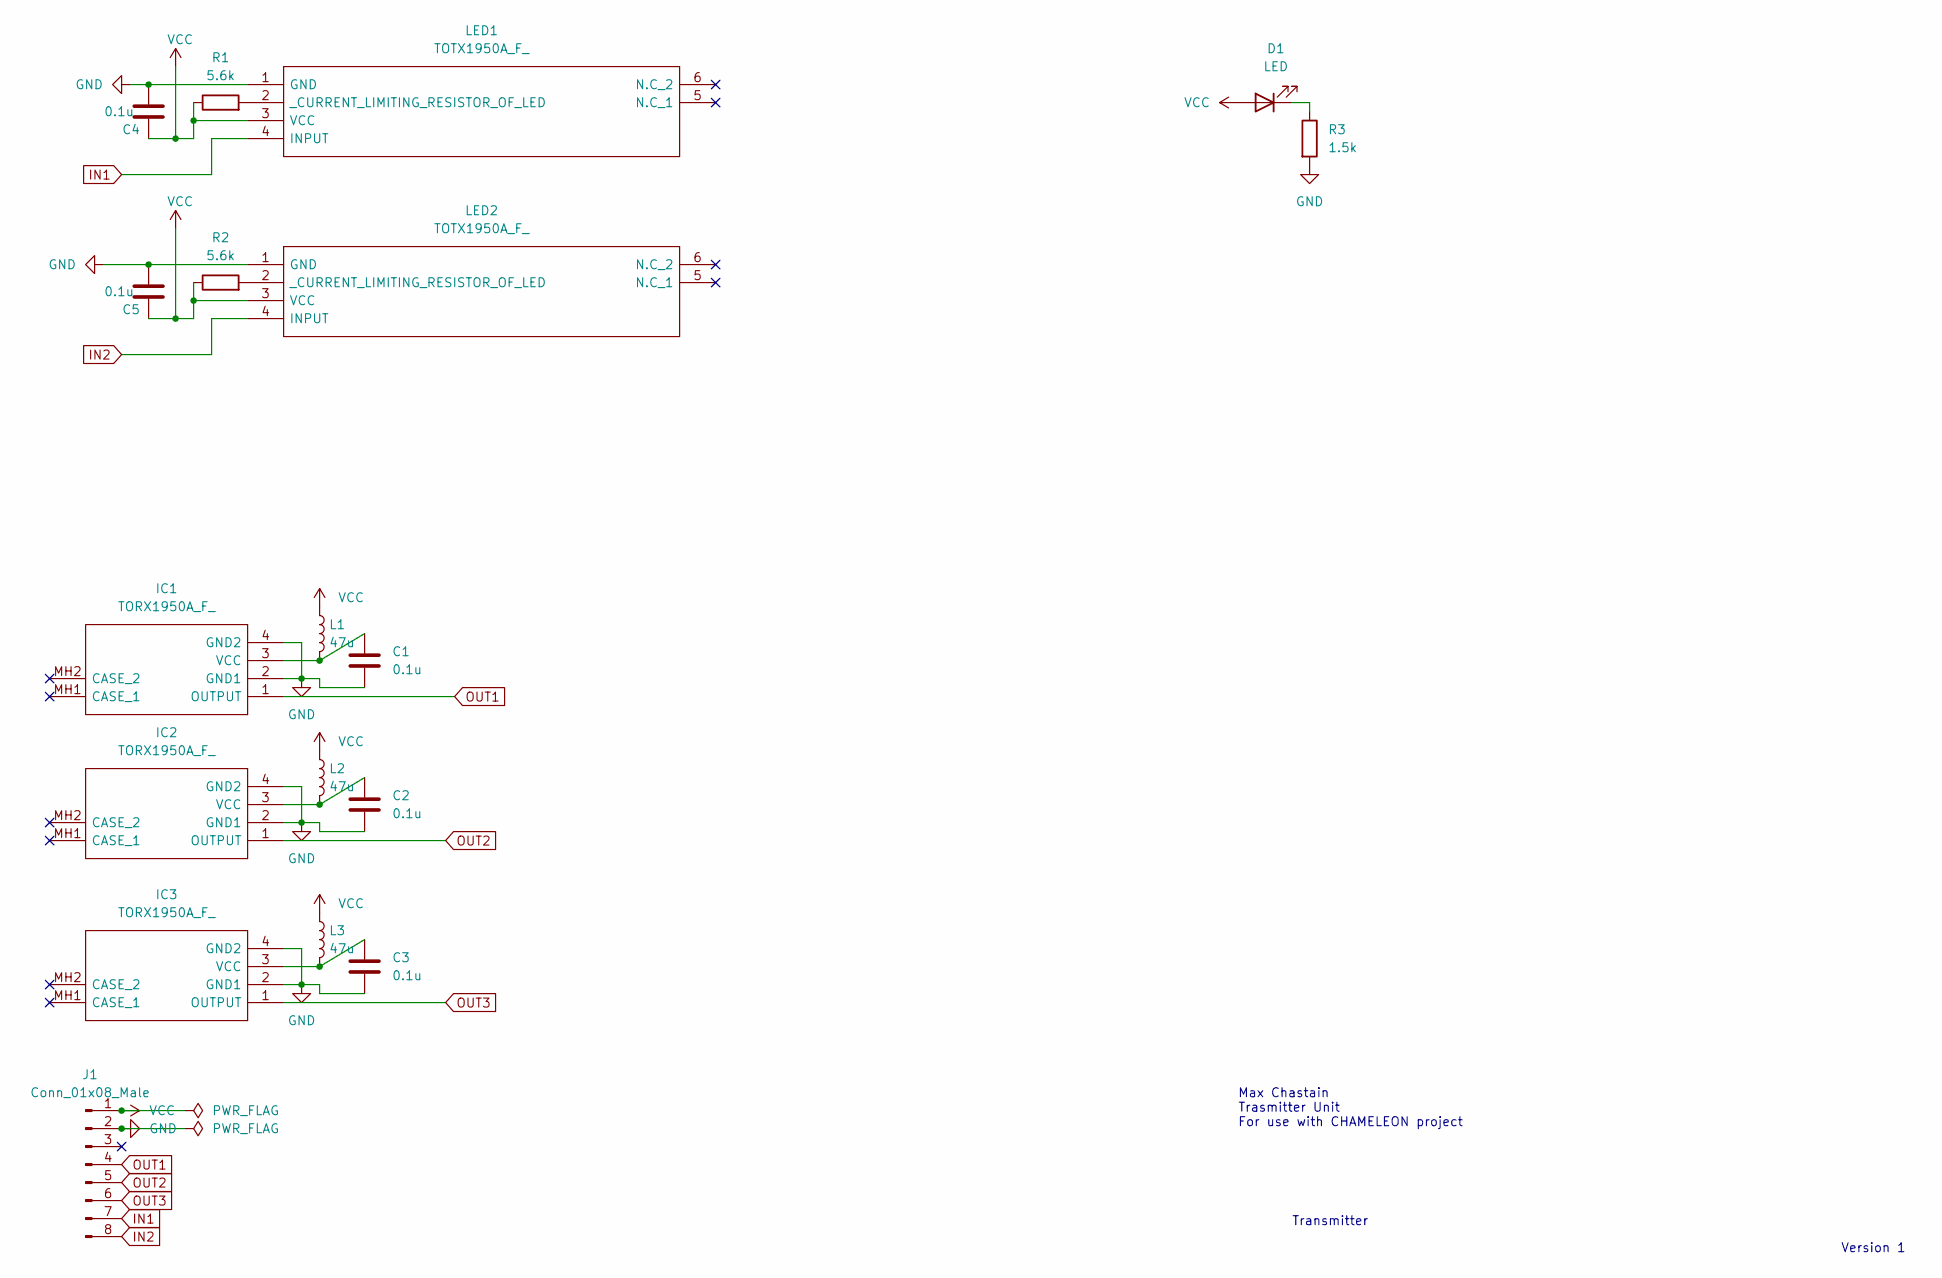
[picture p45: schematic Transmitter.kicad_sch]

Parts:
C1, C2, C3, C4, C5: 0.1u; C_0603_1608Metric_Pad1.08x0.95mm_HandSolder
D1: LED; LED_D8.0mm
IC1, IC2, IC3: TORX1950A_F_; Reverb_BTDR-1H; Mouser Part Number 71-TORX1950A(F)
J1: Conn_01x08_Male; PinHeader_1x08_P2.54mm_Vertical
L1, L2, L3: 47u; L_0603_1608Metric_Pad1.05x0.95mm_HandSolder
LED1, LED2: TOTX1950A_F_; TOTX1950AF; Mouser Part Number 757-TOTX1950AF
R1, R2: 5.6k; R_0603_1608Metric_Pad0.98x0.95mm_HandSolder
R3: 1.5k; R_0805_2012Metric_Pad1.20x1.40mm_HandSolder

Connections:
GND: C1.2, C2.2, C3.2, C4.1, C5.1, IC1.2 (GND1), IC1.4 (GND2), IC2.2 (GND1), IC2.4 (GND2), IC3.2 (GND1), IC3.4 (GND2), J1.2, LED1.1 (GND), LED2.1 (GND), R3.2
IN1: J1.7, LED1.4 (INPUT)
IN2: J1.8, LED2.4 (INPUT)
unnamed: C1.1, IC1.3 (VCC), L1.2
unnamed: C2.1, IC2.3 (VCC), L2.2
unnamed: C3.1, IC3.3 (VCC), L3.2
unnamed: D1.1 (K), R3.1
unnamed: LED1.2 (_CURRENT_LIMITING_RESISTOR_OF_LED), R1.2
unnamed: LED2.2 (_CURRENT_LIMITING_RESISTOR_OF_LED), R2.2
OUT1: IC1.1 (OUTPUT), J1.4
OUT2: IC2.1 (OUTPUT), J1.5
OUT3: IC3.1 (OUTPUT), J1.6
VCC: C4.2, C5.2, D1.2 (A), J1.1, L1.1, L2.1, L3.1, LED1.3 (VCC), LED2.3 (VCC), R1.1, R2.1

Notes on the sheet:
Transmitter
Version 1
Max Chastain Trasmitter Unit For use with CHAMELEON project

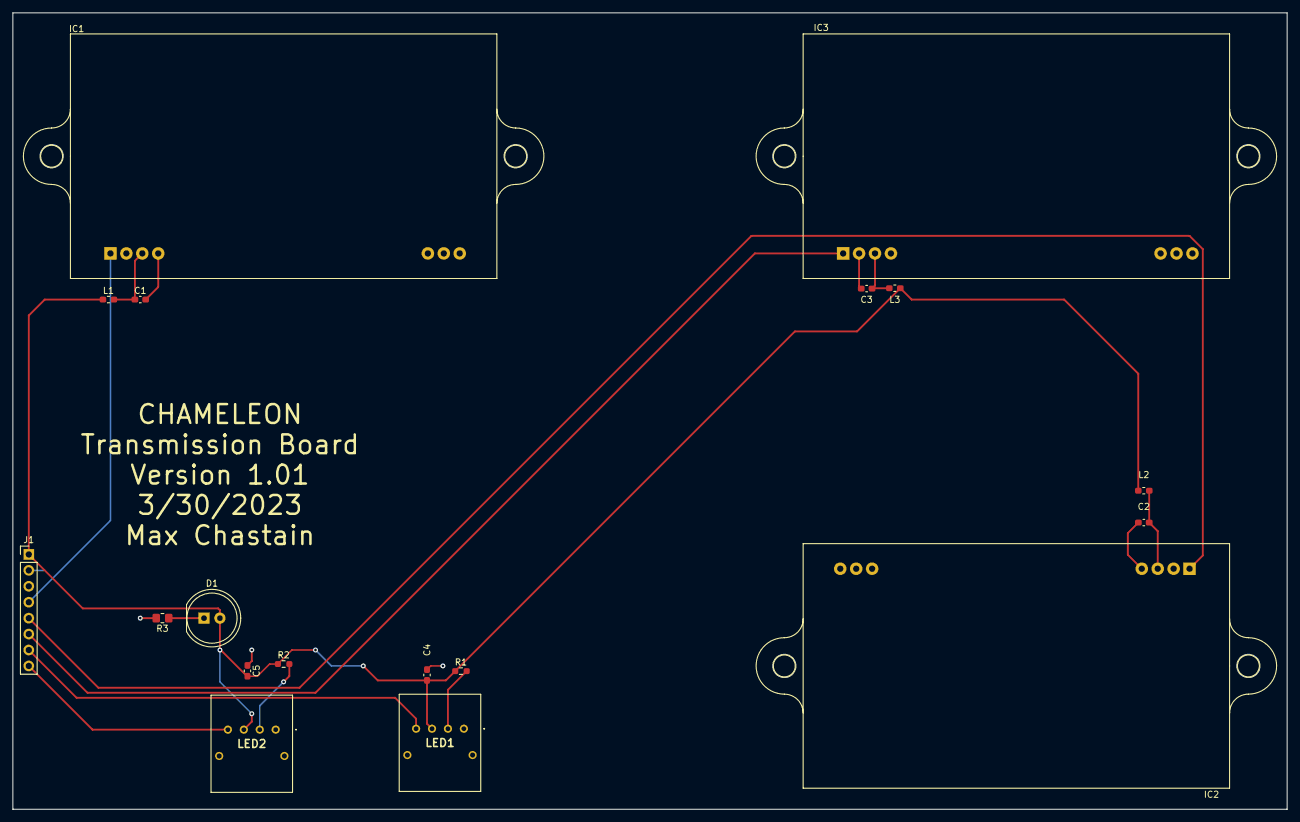
[picture p46: board Transmitter.kicad_pcb from above]

Board: 2 copper layers, 203.2 x 127.0 mm, 18 parts (0 on the bottom side), 13 nets.
