jelkinsjames/chameleon-PCB/DIX/DIX_Board.kicad_pcb

## KiCad design DIX/DIX_Board.kicad_pcb (2023-03-06)

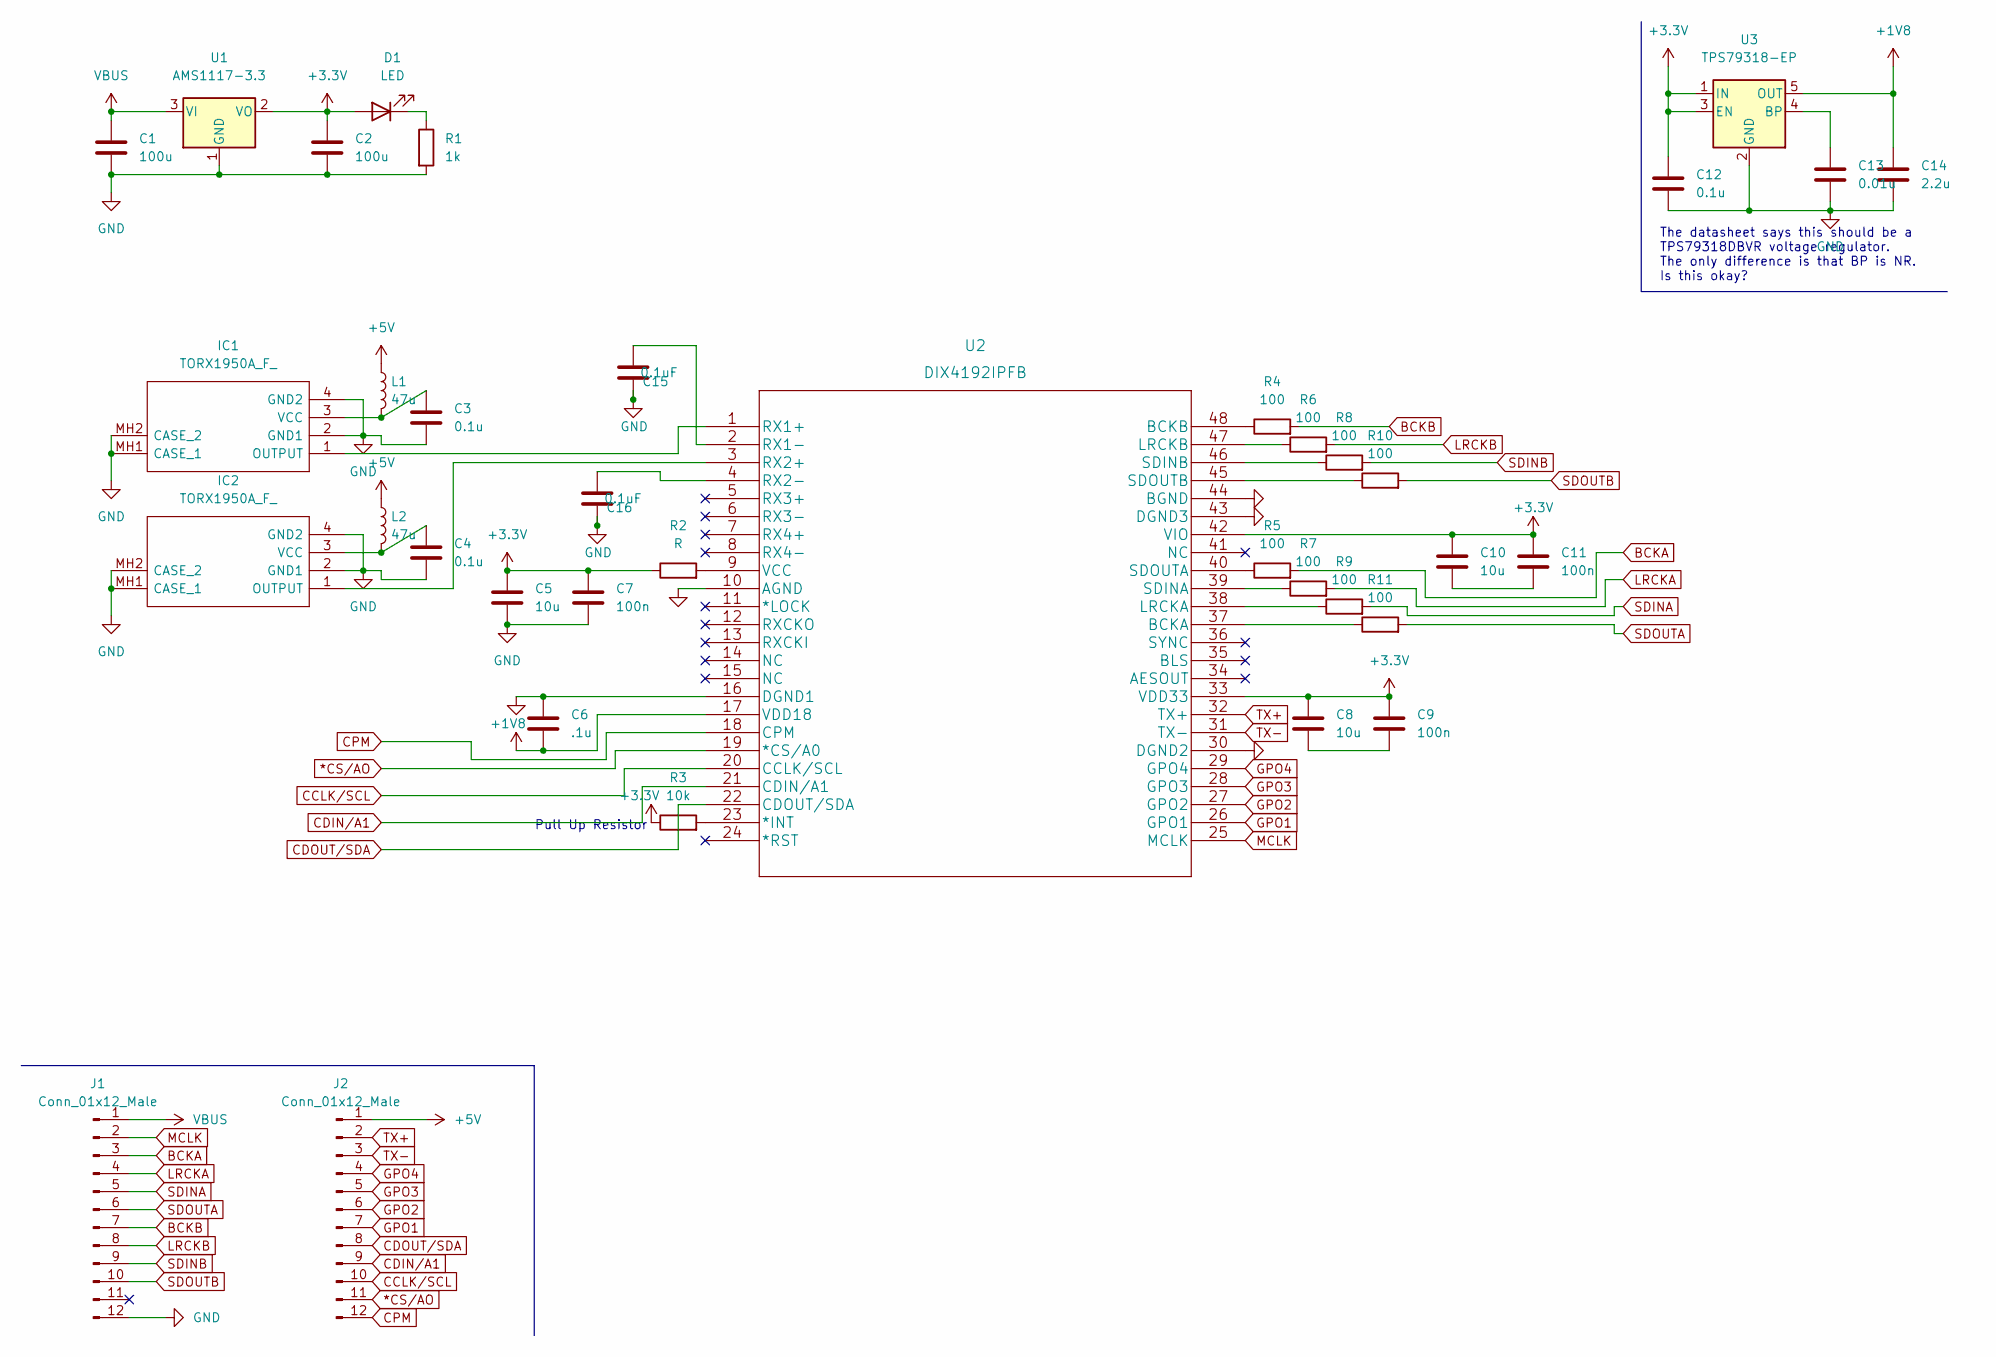
[picture p47: schematic DIX_Board.kicad_sch]

Parts:
C1, C2: 100u; C_0805_2012Metric_Pad1.18x1.45mm_HandSolder
C3, C4: 0.1u; C_0805_2012Metric_Pad1.18x1.45mm_HandSolder
C5, C8, C10: 10u; C_0805_2012Metric
C6: .1u; C_0805_2012Metric
C7, C9, C11: 100n; C_0805_2012Metric
C12: 0.1u; C_0805_2012Metric
C13: 0.01u; C_0805_2012Metric
C14: 2.2u; C_0805_2012Metric
C15, C16: 0.1uF; C_0603_1608Metric_Pad1.08x0.95mm_HandSolder
D1: LED; LED_D8.0mm
IC1, IC2: TORX1950A_F_; Reverb_BTDR-1H; Mouser Part Number 71-TORX1950A(F)
J1, J2: Conn_01x12_Male; PinHeader_1x12_P1.27mm_Vertical
L1, L2: 47u; L_0805_2012Metric_Pad1.05x1.20mm_HandSolder
R1: 1k; R_0805_2012Metric_Pad1.20x1.40mm_HandSolder
R2: R; R_0805_2012Metric_Pad1.20x1.40mm_HandSolder
R3: 10k; R_0805_2012Metric_Pad1.20x1.40mm_HandSolder
R4, R5, R6, R7, R8, R9, R10, R11: 100; R_0805_2012Metric_Pad1.20x1.40mm_HandSolder
U1: AMS1117-3.3; SOT-223-3_TabPin2
U2: DIX4192IPFB
U3: TPS79318-EP; SOT-23-5

Connections:
*CS/AO: J2.11, U2.19 (*CS/A0)
+1V8: C6.2, C14.1, U2.17 (VDD18), U3.5 (OUT)
+3.3V: C2.1, C5.1, C7.1, C8.1, C9.1, C10.1, C11.1, C12.1, D1.2 (A), R2.1, R3.1, U1.2 (VO), U2.33 (VDD33), U2.42 (VIO), U3.1 (IN), U3.3 (EN)
+5V: J2.1, L1.1, L2.1
BCKA: J1.3, R5.2
BCKB: J1.7, R4.2
CCLK/SCL: J2.10, U2.20 (CCLK/SCL)
CDIN/A1: J2.9, U2.21 (CDIN/A1)
CDOUT/SDA: J2.8, U2.22 (CDOUT/SDA)
CPM: J2.12, U2.18 (CPM)
GND: C1.2, C2.2, C3.2, C4.2, C5.2, C6.1, C7.2, C12.2, C13.2, C14.2, C15.1, C16.1, IC1.2 (GND1), IC1.4 (GND2), IC1.MH1 (CASE_1), IC1.MH2 (CASE_2), IC2.2 (GND1), IC2.4 (GND2), IC2.MH1 (CASE_1), IC2.MH2 (CASE_2), J1.12, R1.2, U1.1 (GND), U2.10 (AGND), U2.16 (DGND1), U2.30 (DGND2), U2.43 (DGND3), U2.44 (BGND), U3.2 (GND)
GPO1: J2.7, U2.26 (GPO1)
GPO2: J2.6, U2.27 (GPO2)
GPO3: J2.5, U2.28 (GPO3)
GPO4: J2.4, U2.29 (GPO4)
LRCKA: J1.4, R7.2
LRCKB: J1.8, R6.2
MCLK: J1.2, U2.25 (MCLK)
unnamed: C3.1, IC1.3 (VCC), L1.2
unnamed: C4.1, IC2.3 (VCC), L2.2
unnamed: C8.2, C9.2
unnamed: C10.2, C11.2
unnamed: C13.1, U3.4 (BP)
unnamed: C15.2, U2.2 (RX1-)
unnamed: C16.2, U2.4 (RX2-)
unnamed: D1.1 (K), R1.1
unnamed: IC1.1 (OUTPUT), U2.1 (RX1+)
unnamed: IC2.1 (OUTPUT), U2.3 (RX2+)
unnamed: R2.2, U2.9 (VCC)
unnamed: R3.2, U2.23 (*INT)
unnamed: R4.1, U2.48 (BCKB)
unnamed: R5.1, U2.40 (SDOUTA)
unnamed: R6.1, U2.47 (LRCKB)
unnamed: R7.1, U2.39 (SDINA)
unnamed: R8.1, U2.46 (SDINB)
unnamed: R9.1, U2.38 (LRCKA)
unnamed: R10.1, U2.45 (SDOUTB)
unnamed: R11.1, U2.37 (BCKA)
SDINA: J1.5, R9.2
SDINB: J1.9, R8.2
SDOUTA: J1.6, R11.2
SDOUTB: J1.10, R10.2
TX+: J2.2, U2.32 (TX+)
TX-: J2.3, U2.31 (TX-)
VBUS: C1.1, J1.1, U1.3 (VI)

Notes on the sheet:
The datasheet says this should be a TPS79318DBVR voltage regulator. The only difference is that BP is NR. Is this okay?
Pull Up Resistor

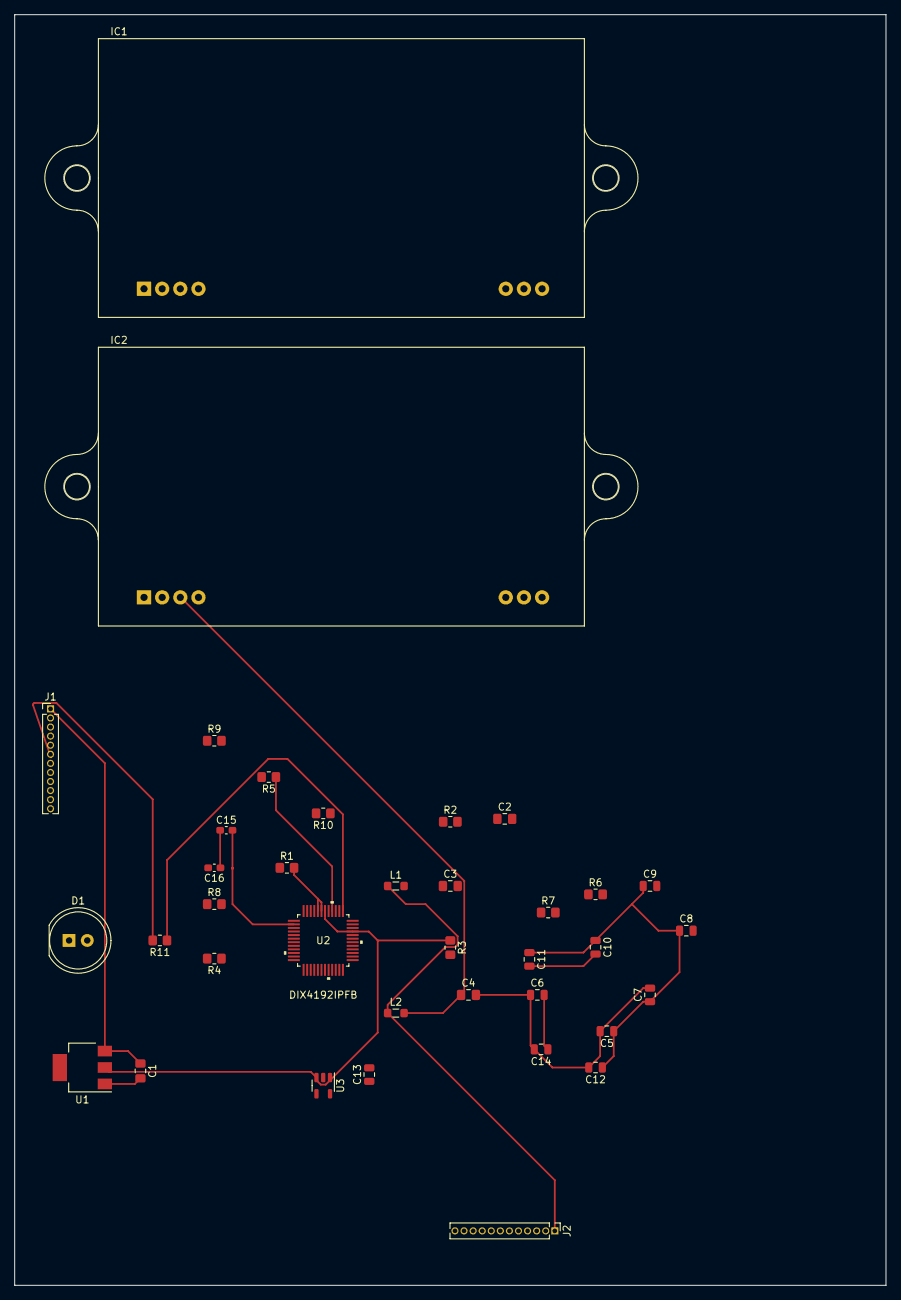
[picture p48: board DIX_Board.kicad_pcb from above]

Board: 2 copper layers, 121.9 x 177.8 mm, 37 parts (0 on the bottom side), 45 nets.
