jelkinsjames/chameleon-PCB/STM32tut/STM32tut.kicad_pcb

## KiCad design STM32tut/STM32tut.kicad_pcb (2023-02-15)

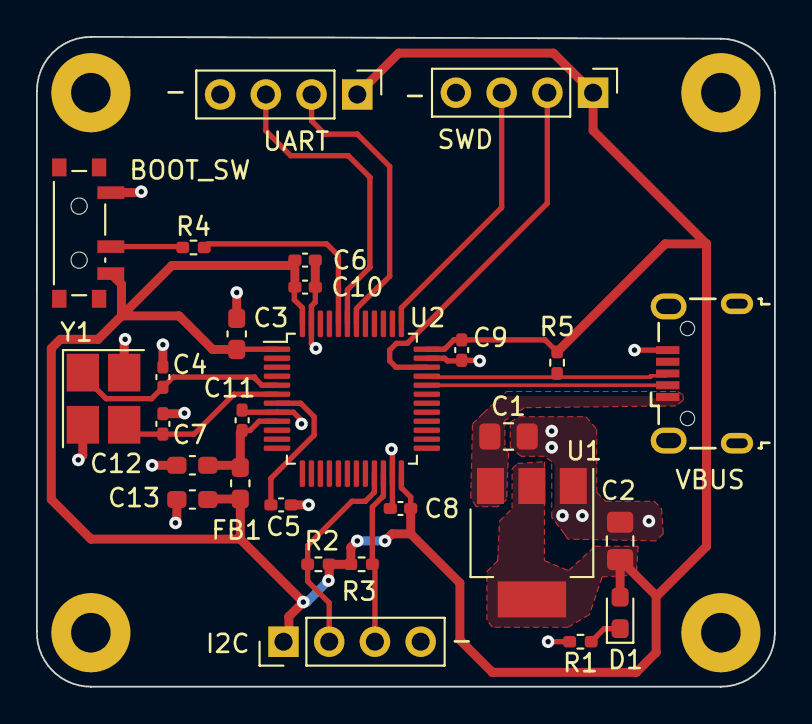
[picture p49: board STM32tut.kicad_pcb from above]

Board: 2 copper layers, 41.0 x 36.1 mm, 32 parts (0 on the bottom side), 18 nets.

Parts:
C1, C2: 22uF; C_0805_2012Metric_Pad1.18x1.45mm_HandSolder
C3: 10uF; C_0603_1608Metric_Pad1.08x0.95mm_HandSolder
C4, C7: 10pF; C_0402_1005Metric_Pad0.74x0.62mm_HandSolder
C5, C6, C8, C9, C10: 100nF; C_0402_1005Metric_Pad0.74x0.62mm_HandSolder
C11: 10nF; C_0402_1005Metric_Pad0.74x0.62mm_HandSolder
C12, C13: 1uF; C_0603_1608Metric_Pad1.08x0.95mm_HandSolder
D1: RED1.8; LED_0603_1608Metric_Pad1.05x0.95mm_HandSolder
FB1: 120R; L_0603_1608Metric_Pad1.05x0.95mm_HandSolder
H1, H2, H3, H4: MountingHole_Pad; MountingHole_2.2mm_M2_Pad
J1, J2, J3: Conn_01x04_Male; PinHeader_1x04_P2.54mm_Vertical
J4: USB_B_Micro; USB_Micro-B_Wuerth_629105150521
R1, R2, R3, R5: 1.5k; R_0402_1005Metric_Pad0.72x0.64mm_HandSolder
R4: 10k; R_0402_1005Metric_Pad0.72x0.64mm_HandSolder
SW1: SW_SPDT; SW_SPDT_PCM12
U1: AMS1117-3.3; SOT-223-3_TabPin2
U2: STM32F103C8T6; LQFP-48_7x7mm_P0.5mm
Y1: 16MHz; Crystal_SMD_3225-4Pin_3.2x2.5mm_HandSoldering

Connections:
+3.3VA: C11.1, C12.1, FB1.1, U2.9 (VDDA)
+3V3: C2.1, C3.1, C6.1, C8.1, C9.1, C10.1, C13.1, D1.2 (A), FB1.2, J1.1, J2.1, J3.1, R2.1, R3.1, R5.1, SW1.3 (C), U1.2 (VO), U2.1 (VBAT), U2.24 (VDD), U2.36 (VDD), U2.48 (VDD)
/BOOT0: R4.2, U2.44 (BOOT0)
/HSE_IN: C4.1, U2.5 (PD0), Y1.1
/HSE_OUT: C7.1, U2.6 (PD1), Y1.3
/I2C2_SCL: J2.2, R2.2, U2.21 (PB10)
/I2C2_SDA: J2.3, R3.2, U2.22 (PB11)
/NRST: C5.1, U2.7 (NRST)
/POWER_LED_K: D1.1 (K), R1.1
/SWCLK: J3.3, U2.37 (PA14)
/SWDIO: J3.2, U2.34 (PA13)
/SW_BOOT0: R4.1, SW1.2 (B)
/UART1_RX: J1.3, U2.43 (PB7)
/UART1_TX: J1.2, U2.42 (PB6)
/USB_D+: J4.3 (D+), R5.2, U2.33 (PA12)
/USB_D-: J4.2 (D-), U2.32 (PA11)
GND: C1.2, C2.2, C3.2, C4.2, C5.2, C6.2, C7.2, C8.2, C9.2, C10.2, C11.2, C12.2, C13.2, H1.1, H2.1, H3.1, H4.1, J1.4, J2.4, J3.4, J4.5 (GND), R1.2, SW1.1 (A), U1.1 (GND), U2.8 (VSSA), U2.23 (VSS), U2.35 (VSS), U2.47 (VSS), Y1.2, Y1.4
VBUS: C1.1, J4.1 (VBUS), U1.3 (VI)
