jelkinsjames/chameleon-PCB/IOBoard_ATSAMD21/firmware/src/packs/ATSAMD21G18A_DFP/pio/samd21g18a.h

/*
 * Peripheral I/O description for SAMD21G18A
 *
 * Copyright (c) 2022 Microchip Technology Inc. and its subsidiaries.
 *
 * Subject to your compliance with these terms, you may use Microchip software and any derivatives
 * exclusively with Microchip products. It is your responsibility to comply with third party license
 * terms applicable to your use of third party software (including open source software) that may
 * accompany Microchip software.
 *
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
 * IN NO EVENT WILL MICROCHIP BE LIABLE FOR ANY INDIRECT, SPECIAL, PUNITIVE, INCIDENTAL OR CONSEQUENTIAL
 * LOSS, DAMAGE, COST OR EXPENSE OF ANY KIND WHATSOEVER RELATED TO THE SOFTWARE, HOWEVER CAUSED, EVEN IF
 * MICROCHIP HAS BEEN ADVISED OF THE POSSIBILITY OR THE DAMAGES ARE FORESEEABLE. TO THE FULLEST EXTENT
 * ALLOWED BY LAW, MICROCHIP'S TOTAL LIABILITY ON ALL CLAIMS IN ANY WAY RELATED TO THIS SOFTWARE WILL NOT
 * EXCEED THE AMOUNT OF FEES, IF ANY, THAT YOU HAVE PAID DIRECTLY TO MICROCHIP FOR THIS SOFTWARE.
 *
 */

/* file generated from device description version 2019-11-25T06:52:26Z */
#ifndef _SAMD21G18A_GPIO_H_
#define _SAMD21G18A_GPIO_H_

/* ========== Peripheral I/O pin numbers ========== */
#define PIN_PA00                    (    0)  /**< Pin Number for PA00 */
#define PIN_PA01                    (    1)  /**< Pin Number for PA01 */
#define PIN_PA02                    (    2)  /**< Pin Number for PA02 */
#define PIN_PA03                    (    3)  /**< Pin Number for PA03 */
#define PIN_PA04                    (    4)  /**< Pin Number for PA04 */
#define PIN_PA05                    (    5)  /**< Pin Number for PA05 */
#define PIN_PA06                    (    6)  /**< Pin Number for PA06 */
#define PIN_PA07                    (    7)  /**< Pin Number for PA07 */
#define PIN_PA08                    (    8)  /**< Pin Number for PA08 */
#define PIN_PA09                    (    9)  /**< Pin Number for PA09 */
#define PIN_PA10                    (   10)  /**< Pin Number for PA10 */
#define PIN_PA11                    (   11)  /**< Pin Number for PA11 */
#define PIN_PA12                    (   12)  /**< Pin Number for PA12 */
#define PIN_PA13                    (   13)  /**< Pin Number for PA13 */
#define PIN_PA14                    (   14)  /**< Pin Number for PA14 */
#define PIN_PA15                    (   15)  /**< Pin Number for PA15 */
#define PIN_PA16                    (   16)  /**< Pin Number for PA16 */
#define PIN_PA17                    (   17)  /**< Pin Number for PA17 */
#define PIN_PA18                    (   18)  /**< Pin Number for PA18 */
#define PIN_PA19                    (   19)  /**< Pin Number for PA19 */
#define PIN_PA20                    (   20)  /**< Pin Number for PA20 */
#define PIN_PA21                    (   21)  /**< Pin Number for PA21 */
#define PIN_PA22                    (   22)  /**< Pin Number for PA22 */
#define PIN_PA23                    (   23)  /**< Pin Number for PA23 */
#define PIN_PA24                    (   24)  /**< Pin Number for PA24 */
#define PIN_PA25                    (   25)  /**< Pin Number for PA25 */
#define PIN_PA27                    (   27)  /**< Pin Number for PA27 */
#define PIN_PA28                    (   28)  /**< Pin Number for PA28 */
#define PIN_PA30                    (   30)  /**< Pin Number for PA30 */
#define PIN_PA31                    (   31)  /**< Pin Number for PA31 */
#define PIN_PB02                    (   34)  /**< Pin Number for PB02 */
#define PIN_PB03                    (   35)  /**< Pin Number for PB03 */
#define PIN_PB08                    (   40)  /**< Pin Number for PB08 */
#define PIN_PB09                    (   41)  /**< Pin Number for PB09 */
#define PIN_PB10                    (   42)  /**< Pin Number for PB10 */
#define PIN_PB11                    (   43)  /**< Pin Number for PB11 */
#define PIN_PB22                    (   54)  /**< Pin Number for PB22 */
#define PIN_PB23                    (   55)  /**< Pin Number for PB23 */

/* ========== Peripheral I/O masks ========== */
#define PORT_PA00                   (_UINT32_(1) << 0) /**< PORT mask for PA00 */
#define PORT_PA01                   (_UINT32_(1) << 1) /**< PORT mask for PA01 */
#define PORT_PA02                   (_UINT32_(1) << 2) /**< PORT mask for PA02 */
#define PORT_PA03                   (_UINT32_(1) << 3) /**< PORT mask for PA03 */
#define PORT_PA04                   (_UINT32_(1) << 4) /**< PORT mask for PA04 */
#define PORT_PA05                   (_UINT32_(1) << 5) /**< PORT mask for PA05 */
#define PORT_PA06                   (_UINT32_(1) << 6) /**< PORT mask for PA06 */
#define PORT_PA07                   (_UINT32_(1) << 7) /**< PORT mask for PA07 */
#define PORT_PA08                   (_UINT32_(1) << 8) /**< PORT mask for PA08 */
#define PORT_PA09                   (_UINT32_(1) << 9) /**< PORT mask for PA09 */
#define PORT_PA10                   (_UINT32_(1) << 10) /**< PORT mask for PA10 */
#define PORT_PA11                   (_UINT32_(1) << 11) /**< PORT mask for PA11 */
#define PORT_PA12                   (_UINT32_(1) << 12) /**< PORT mask for PA12 */
#define PORT_PA13                   (_UINT32_(1) << 13) /**< PORT mask for PA13 */
#define PORT_PA14                   (_UINT32_(1) << 14) /**< PORT mask for PA14 */
#define PORT_PA15                   (_UINT32_(1) << 15) /**< PORT mask for PA15 */
#define PORT_PA16                   (_UINT32_(1) << 16) /**< PORT mask for PA16 */
#define PORT_PA17                   (_UINT32_(1) << 17) /**< PORT mask for PA17 */
#define PORT_PA18                   (_UINT32_(1) << 18) /**< PORT mask for PA18 */
#define PORT_PA19                   (_UINT32_(1) << 19) /**< PORT mask for PA19 */
#define PORT_PA20                   (_UINT32_(1) << 20) /**< PORT mask for PA20 */
#define PORT_PA21                   (_UINT32_(1) << 21) /**< PORT mask for PA21 */
#define PORT_PA22                   (_UINT32_(1) << 22) /**< PORT mask for PA22 */
#define PORT_PA23                   (_UINT32_(1) << 23) /**< PORT mask for PA23 */
#define PORT_PA24                   (_UINT32_(1) << 24) /**< PORT mask for PA24 */
#define PORT_PA25                   (_UINT32_(1) << 25) /**< PORT mask for PA25 */
#define PORT_PA27                   (_UINT32_(1) << 27) /**< PORT mask for PA27 */
#define PORT_PA28                   (_UINT32_(1) << 28) /**< PORT mask for PA28 */
#define PORT_PA30                   (_UINT32_(1) << 30) /**< PORT mask for PA30 */
#define PORT_PA31                   (_UINT32_(1) << 31) /**< PORT mask for PA31 */
#define PORT_PB02                   (_UINT32_(1) << 2) /**< PORT mask for PB02 */
#define PORT_PB03                   (_UINT32_(1) << 3) /**< PORT mask for PB03 */
#define PORT_PB08                   (_UINT32_(1) << 8) /**< PORT mask for PB08 */
#define PORT_PB09                   (_UINT32_(1) << 9) /**< PORT mask for PB09 */
#define PORT_PB10                   (_UINT32_(1) << 10) /**< PORT mask for PB10 */
#define PORT_PB11                   (_UINT32_(1) << 11) /**< PORT mask for PB11 */
#define PORT_PB22                   (_UINT32_(1) << 22) /**< PORT mask for PB22 */
#define PORT_PB23                   (_UINT32_(1) << 23) /**< PORT mask for PB23 */

/* ========== PORT definition for AC peripheral ========== */
#define PIN_PA04B_AC_AIN0                          _UINT32_(4) 
#define MUX_PA04B_AC_AIN0                          _UINT32_(1) 
#define PINMUX_PA04B_AC_AIN0                       ((PIN_PA04B_AC_AIN0 << 16) | MUX_PA04B_AC_AIN0)
#define PORT_PA04B_AC_AIN0                         (_UINT32_(1) << 4)

#define PIN_PA05B_AC_AIN1                          _UINT32_(5) 
#define MUX_PA05B_AC_AIN1                          _UINT32_(1) 
#define PINMUX_PA05B_AC_AIN1                       ((PIN_PA05B_AC_AIN1 << 16) | MUX_PA05B_AC_AIN1)
#define PORT_PA05B_AC_AIN1                         (_UINT32_(1) << 5)

#define PIN_PA06B_AC_AIN2                          _UINT32_(6) 
#define MUX_PA06B_AC_AIN2                          _UINT32_(1) 
#define PINMUX_PA06B_AC_AIN2                       ((PIN_PA06B_AC_AIN2 << 16) | MUX_PA06B_AC_AIN2)
#define PORT_PA06B_AC_AIN2                         (_UINT32_(1) << 6)

#define PIN_PA07B_AC_AIN3                          _UINT32_(7) 
#define MUX_PA07B_AC_AIN3                          _UINT32_(1) 
#define PINMUX_PA07B_AC_AIN3                       ((PIN_PA07B_AC_AIN3 << 16) | MUX_PA07B_AC_AIN3)
#define PORT_PA07B_AC_AIN3                         (_UINT32_(1) << 7)

#define PIN_PA12H_AC_CMP0                          _UINT32_(12)
#define MUX_PA12H_AC_CMP0                          _UINT32_(7) 
#define PINMUX_PA12H_AC_CMP0                       ((PIN_PA12H_AC_CMP0 << 16) | MUX_PA12H_AC_CMP0)
#define PORT_PA12H_AC_CMP0                         (_UINT32_(1) << 12)

#define PIN_PA18H_AC_CMP0                          _UINT32_(18)
#define MUX_PA18H_AC_CMP0                          _UINT32_(7) 
#define PINMUX_PA18H_AC_CMP0                       ((PIN_PA18H_AC_CMP0 << 16) | MUX_PA18H_AC_CMP0)
#define PORT_PA18H_AC_CMP0                         (_UINT32_(1) << 18)

#define PIN_PA13H_AC_CMP1                          _UINT32_(13)
#define MUX_PA13H_AC_CMP1                          _UINT32_(7) 
#define PINMUX_PA13H_AC_CMP1                       ((PIN_PA13H_AC_CMP1 << 16) | MUX_PA13H_AC_CMP1)
#define PORT_PA13H_AC_CMP1                         (_UINT32_(1) << 13)

#define PIN_PA19H_AC_CMP1                          _UINT32_(19)
#define MUX_PA19H_AC_CMP1                          _UINT32_(7) 
#define PINMUX_PA19H_AC_CMP1                       ((PIN_PA19H_AC_CMP1 << 16) | MUX_PA19H_AC_CMP1)
#define PORT_PA19H_AC_CMP1                         (_UINT32_(1) << 19)

/* ========== PORT definition for ADC peripheral ========== */
#define PIN_PA02B_ADC_AIN0                         _UINT32_(2) 
#define MUX_PA02B_ADC_AIN0                         _UINT32_(1) 
#define PINMUX_PA02B_ADC_AIN0                      ((PIN_PA02B_ADC_AIN0 << 16) | MUX_PA02B_ADC_AIN0)
#define PORT_PA02B_ADC_AIN0                        (_UINT32_(1) << 2)

#define PIN_PA03B_ADC_AIN1                         _UINT32_(3) 
#define MUX_PA03B_ADC_AIN1                         _UINT32_(1) 
#define PINMUX_PA03B_ADC_AIN1                      ((PIN_PA03B_ADC_AIN1 << 16) | MUX_PA03B_ADC_AIN1)
#define PORT_PA03B_ADC_AIN1                        (_UINT32_(1) << 3)

#define PIN_PB08B_ADC_AIN2                         _UINT32_(40)
#define MUX_PB08B_ADC_AIN2                         _UINT32_(1) 
#define PINMUX_PB08B_ADC_AIN2                      ((PIN_PB08B_ADC_AIN2 << 16) | MUX_PB08B_ADC_AIN2)
#define PORT_PB08B_ADC_AIN2                        (_UINT32_(1) << 8)

#define PIN_PB09B_ADC_AIN3                         _UINT32_(41)
#define MUX_PB09B_ADC_AIN3                         _UINT32_(1) 
#define PINMUX_PB09B_ADC_AIN3                      ((PIN_PB09B_ADC_AIN3 << 16) | MUX_PB09B_ADC_AIN3)
#define PORT_PB09B_ADC_AIN3                        (_UINT32_(1) << 9)

#define PIN_PA04B_ADC_AIN4                         _UINT32_(4) 
#define MUX_PA04B_ADC_AIN4                         _UINT32_(1) 
#define PINMUX_PA04B_ADC_AIN4                      ((PIN_PA04B_ADC_AIN4 << 16) | MUX_PA04B_ADC_AIN4)
#define PORT_PA04B_ADC_AIN4                        (_UINT32_(1) << 4)

#define PIN_PA05B_ADC_AIN5                         _UINT32_(5) 
#define MUX_PA05B_ADC_AIN5                         _UINT32_(1) 
#define PINMUX_PA05B_ADC_AIN5                      ((PIN_PA05B_ADC_AIN5 << 16) | MUX_PA05B_ADC_AIN5)
#define PORT_PA05B_ADC_AIN5                        (_UINT32_(1) << 5)

#define PIN_PA06B_ADC_AIN6                         _UINT32_(6) 
#define MUX_PA06B_ADC_AIN6                         _UINT32_(1) 
#define PINMUX_PA06B_ADC_AIN6                      ((PIN_PA06B_ADC_AIN6 << 16) | MUX_PA06B_ADC_AIN6)
#define PORT_PA06B_ADC_AIN6                        (_UINT32_(1) << 6)

#define PIN_PA07B_ADC_AIN7                         _UINT32_(7) 
#define MUX_PA07B_ADC_AIN7                         _UINT32_(1) 
#define PINMUX_PA07B_ADC_AIN7                      ((PIN_PA07B_ADC_AIN7 << 16) | MUX_PA07B_ADC_AIN7)
#define PORT_PA07B_ADC_AIN7                        (_UINT32_(1) << 7)

#define PIN_PB02B_ADC_AIN10                        _UINT32_(34)
#define MUX_PB02B_ADC_AIN10                        _UINT32_(1) 
#define PINMUX_PB02B_ADC_AIN10                     ((PIN_PB02B_ADC_AIN10 << 16) | MUX_PB02B_ADC_AIN10)
#define PORT_PB02B_ADC_AIN10                       (_UINT32_(1) << 2)

#define PIN_PB03B_ADC_AIN11                        _UINT32_(35)
#define MUX_PB03B_ADC_AIN11                        _UINT32_(1) 
#define PINMUX_PB03B_ADC_AIN11                     ((PIN_PB03B_ADC_AIN11 << 16) | MUX_PB03B_ADC_AIN11)
#define PORT_PB03B_ADC_AIN11                       (_UINT32_(1) << 3)

#define PIN_PA08B_ADC_AIN16                        _UINT32_(8) 
#define MUX_PA08B_ADC_AIN16                        _UINT32_(1) 
#define PINMUX_PA08B_ADC_AIN16                     ((PIN_PA08B_ADC_AIN16 << 16) | MUX_PA08B_ADC_AIN16)
#define PORT_PA08B_ADC_AIN16                       (_UINT32_(1) << 8)

#define PIN_PA09B_ADC_AIN17                        _UINT32_(9) 
#define MUX_PA09B_ADC_AIN17                        _UINT32_(1) 
#define PINMUX_PA09B_ADC_AIN17                     ((PIN_PA09B_ADC_AIN17 << 16) | MUX_PA09B_ADC_AIN17)
#define PORT_PA09B_ADC_AIN17                       (_UINT32_(1) << 9)

#define PIN_PA10B_ADC_AIN18                        _UINT32_(10)
#define MUX_PA10B_ADC_AIN18                        _UINT32_(1) 
#define PINMUX_PA10B_ADC_AIN18                     ((PIN_PA10B_ADC_AIN18 << 16) | MUX_PA10B_ADC_AIN18)
#define PORT_PA10B_ADC_AIN18                       (_UINT32_(1) << 10)

#define PIN_PA11B_ADC_AIN19                        _UINT32_(11)
#define MUX_PA11B_ADC_AIN19                        _UINT32_(1) 
#define PINMUX_PA11B_ADC_AIN19                     ((PIN_PA11B_ADC_AIN19 << 16) | MUX_PA11B_ADC_AIN19)
#define PORT_PA11B_ADC_AIN19                       (_UINT32_(1) << 11)

#define PIN_PA04B_ADC_VREFP                        _UINT32_(4) 
#define MUX_PA04B_ADC_VREFP                        _UINT32_(1) 
#define PINMUX_PA04B_ADC_VREFP                     ((PIN_PA04B_ADC_VREFP << 16) | MUX_PA04B_ADC_VREFP)
#define PORT_PA04B_ADC_VREFP                       (_UINT32_(1) << 4)

/* ========== PORT definition for DAC peripheral ========== */
#define PIN_PA02B_DAC_VOUT                         _UINT32_(2) 
#define MUX_PA02B_DAC_VOUT                         _UINT32_(1) 
#define PINMUX_PA02B_DAC_VOUT                      ((PIN_PA02B_DAC_VOUT << 16) | MUX_PA02B_DAC_VOUT)
#define PORT_PA02B_DAC_VOUT                        (_UINT32_(1) << 2)

#define PIN_PA03B_DAC_VREFP                        _UINT32_(3) 
#define MUX_PA03B_DAC_VREFP                        _UINT32_(1) 
#define PINMUX_PA03B_DAC_VREFP                     ((PIN_PA03B_DAC_VREFP << 16) | MUX_PA03B_DAC_VREFP)
#define PORT_PA03B_DAC_VREFP                       (_UINT32_(1) << 3)

/* ========== PORT definition for EIC peripheral ========== */
#define PIN_PA16A_EIC_EXTINT0                      _UINT32_(16)
#define MUX_PA16A_EIC_EXTINT0                      _UINT32_(0) 
#define PINMUX_PA16A_EIC_EXTINT0                   ((PIN_PA16A_EIC_EXTINT0 << 16) | MUX_PA16A_EIC_EXTINT0)
#define PORT_PA16A_EIC_EXTINT0                     (_UINT32_(1) << 16)
#define PIN_PA16A_EIC_EXTINT_NUM                   _UINT32_(0)  /* EIC signal: PIN_PA16 External Interrupt Line */

#define PIN_PA00A_EIC_EXTINT0                      _UINT32_(0) 
#define MUX_PA00A_EIC_EXTINT0                      _UINT32_(0) 
#define PINMUX_PA00A_EIC_EXTINT0                   ((PIN_PA00A_EIC_EXTINT0 << 16) | MUX_PA00A_EIC_EXTINT0)
#define PORT_PA00A_EIC_EXTINT0                     (_UINT32_(1) << 0)
#define PIN_PA00A_EIC_EXTINT_NUM                   _UINT32_(0)  /* EIC signal: PIN_PA00 External Interrupt Line */

#define PIN_PA17A_EIC_EXTINT1                      _UINT32_(17)
#define MUX_PA17A_EIC_EXTINT1                      _UINT32_(0) 
#define PINMUX_PA17A_EIC_EXTINT1                   ((PIN_PA17A_EIC_EXTINT1 << 16) | MUX_PA17A_EIC_EXTINT1)
#define PORT_PA17A_EIC_EXTINT1                     (_UINT32_(1) << 17)
#define PIN_PA17A_EIC_EXTINT_NUM                   _UINT32_(1)  /* EIC signal: PIN_PA17 External Interrupt Line */

#define PIN_PA01A_EIC_EXTINT1                      _UINT32_(1) 
#define MUX_PA01A_EIC_EXTINT1                      _UINT32_(0) 
#define PINMUX_PA01A_EIC_EXTINT1                   ((PIN_PA01A_EIC_EXTINT1 << 16) | MUX_PA01A_EIC_EXTINT1)
#define PORT_PA01A_EIC_EXTINT1                     (_UINT32_(1) << 1)
#define PIN_PA01A_EIC_EXTINT_NUM                   _UINT32_(1)  /* EIC signal: PIN_PA01 External Interrupt Line */

#define PIN_PA18A_EIC_EXTINT2                      _UINT32_(18)
#define MUX_PA18A_EIC_EXTINT2                      _UINT32_(0) 
#define PINMUX_PA18A_EIC_EXTINT2                   ((PIN_PA18A_EIC_EXTINT2 << 16) | MUX_PA18A_EIC_EXTINT2)
#define PORT_PA18A_EIC_EXTINT2                     (_UINT32_(1) << 18)
#define PIN_PA18A_EIC_EXTINT_NUM                   _UINT32_(2)  /* EIC signal: PIN_PA18 External Interrupt Line */

#define PIN_PA02A_EIC_EXTINT2                      _UINT32_(2) 
#define MUX_PA02A_EIC_EXTINT2                      _UINT32_(0) 
#define PINMUX_PA02A_EIC_EXTINT2                   ((PIN_PA02A_EIC_EXTINT2 << 16) | MUX_PA02A_EIC_EXTINT2)
#define PORT_PA02A_EIC_EXTINT2                     (_UINT32_(1) << 2)
#define PIN_PA02A_EIC_EXTINT_NUM                   _UINT32_(2)  /* EIC signal: PIN_PA02 External Interrupt Line */

#define PIN_PB02A_EIC_EXTINT2                      _UINT32_(34)
#define MUX_PB02A_EIC_EXTINT2                      _UINT32_(0) 
#define PINMUX_PB02A_EIC_EXTINT2                   ((PIN_PB02A_EIC_EXTINT2 << 16) | MUX_PB02A_EIC_EXTINT2)
#define PORT_PB02A_EIC_EXTINT2                     (_UINT32_(1) << 2)
#define PIN_PB02A_EIC_EXTINT_NUM                   _UINT32_(2)  /* EIC signal: PIN_PB02 External Interrupt Line */

#define PIN_PA03A_EIC_EXTINT3                      _UINT32_(3) 
#define MUX_PA03A_EIC_EXTINT3                      _UINT32_(0) 
#define PINMUX_PA03A_EIC_EXTINT3                   ((PIN_PA03A_EIC_EXTINT3 << 16) | MUX_PA03A_EIC_EXTINT3)
#define PORT_PA03A_EIC_EXTINT3                     (_UINT32_(1) << 3)
#define PIN_PA03A_EIC_EXTINT_NUM                   _UINT32_(3)  /* EIC signal: PIN_PA03 External Interrupt Line */

#define PIN_PA19A_EIC_EXTINT3                      _UINT32_(19)
#define MUX_PA19A_EIC_EXTINT3                      _UINT32_(0) 
#define PINMUX_PA19A_EIC_EXTINT3                   ((PIN_PA19A_EIC_EXTINT3 << 16) | MUX_PA19A_EIC_EXTINT3)
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
#define PINMUX_PA23A_EIC_EXTINT7                   ((PIN_PA23A_EIC_EXTINT7 << 16) | MUX_PA23A_EIC_EXTINT7)
#define PORT_PA23A_EIC_EXTINT7                     (_UINT32_(1) << 23)
#define PIN_PA23A_EIC_EXTINT_NUM                   _UINT32_(7)  /* EIC signal: PIN_PA23 External Interrupt Line */

#define PIN_PB23A_EIC_EXTINT7                      _UINT32_(55)
#define MUX_PB23A_EIC_EXTINT7                      _UINT32_(0) 
#define PINMUX_PB23A_EIC_EXTINT7                   ((PIN_PB23A_EIC_EXTINT7 << 16) | MUX_PB23A_EIC_EXTINT7)
#define PORT_PB23A_EIC_EXTINT7                     (_UINT32_(1) << 23)
#define PIN_PB23A_EIC_EXTINT_NUM                   _UINT32_(7)  /* EIC signal: PIN_PB23 External Interrupt Line */

#define PIN_PA28A_EIC_EXTINT8                      _UINT32_(28)
#define MUX_PA28A_EIC_EXTINT8                      _UINT32_(0) 
#define PINMUX_PA28A_EIC_EXTINT8                   ((PIN_PA28A_EIC_EXTINT8 << 16) | MUX_PA28A_EIC_EXTINT8)
#define PORT_PA28A_EIC_EXTINT8                     (_UINT32_(1) << 28)
#define PIN_PA28A_EIC_EXTINT_NUM                   _UINT32_(8)  /* EIC signal: PIN_PA28 External Interrupt Line */

#define PIN_PB08A_EIC_EXTINT8                      _UINT32_(40)
#define MUX_PB08A_EIC_EXTINT8                      _UINT32_(0) 
#define PINMUX_PB08A_EIC_EXTINT8                   ((PIN_PB08A_EIC_EXTINT8 << 16) | MUX_PB08A_EIC_EXTINT8)
#define PORT_PB08A_EIC_EXTINT8                     (_UINT32_(1) << 8)
#define PIN_PB08A_EIC_EXTINT_NUM                   _UINT32_(8)  /* EIC signal: PIN_PB08 External Interrupt Line */

#define PIN_PA09A_EIC_EXTINT9                      _UINT32_(9) 
#define MUX_PA09A_EIC_EXTINT9                      _UINT32_(0) 
#define PINMUX_PA09A_EIC_EXTINT9                   ((PIN_PA09A_EIC_EXTINT9 << 16) | MUX_PA09A_EIC_EXTINT9)
#define PORT_PA09A_EIC_EXTINT9                     (_UINT32_(1) << 9)
#define PIN_PA09A_EIC_EXTINT_NUM                   _UINT32_(9)  /* EIC signal: PIN_PA09 External Interrupt Line */

#define PIN_PB09A_EIC_EXTINT9                      _UINT32_(41)
#define MUX_PB09A_EIC_EXTINT9                      _UINT32_(0) 
#define PINMUX_PB09A_EIC_EXTINT9                   ((PIN_PB09A_EIC_EXTINT9 << 16) | MUX_PB09A_EIC_EXTINT9)
#define PORT_PB09A_EIC_EXTINT9                     (_UINT32_(1) << 9)
#define PIN_PB09A_EIC_EXTINT_NUM                   _UINT32_(9)  /* EIC signal: PIN_PB09 External Interrupt Line */

#define PIN_PA10A_EIC_EXTINT10                     _UINT32_(10)
#define MUX_PA10A_EIC_EXTINT10                     _UINT32_(0) 
#define PINMUX_PA10A_EIC_EXTINT10                  ((PIN_PA10A_EIC_EXTINT10 << 16) | MUX_PA10A_EIC_EXTINT10)
#define PORT_PA10A_EIC_EXTINT10                    (_UINT32_(1) << 10)
#define PIN_PA10A_EIC_EXTINT_NUM                   _UINT32_(10) /* EIC signal: PIN_PA10 External Interrupt Line */

#define PIN_PA30A_EIC_EXTINT10                     _UINT32_(30)
#define MUX_PA30A_EIC_EXTINT10                     _UINT32_(0) 
#define PINMUX_PA30A_EIC_EXTINT10                  ((PIN_PA30A_EIC_EXTINT10 << 16) | MUX_PA30A_EIC_EXTINT10)
#define PORT_PA30A_EIC_EXTINT10                    (_UINT32_(1) << 30)
#define PIN_PA30A_EIC_EXTINT_NUM                   _UINT32_(10) /* EIC signal: PIN_PA30 External Interrupt Line */

#define PIN_PB10A_EIC_EXTINT10                     _UINT32_(42)
#define MUX_PB10A_EIC_EXTINT10                     _UINT32_(0) 
#define PINMUX_PB10A_EIC_EXTINT10                  ((PIN_PB10A_EIC_EXTINT10 << 16) | MUX_PB10A_EIC_EXTINT10)
#define PORT_PB10A_EIC_EXTINT10                    (_UINT32_(1) << 10)
#define PIN_PB10A_EIC_EXTINT_NUM                   _UINT32_(10) /* EIC signal: PIN_PB10 External Interrupt Line */

#define PIN_PA11A_EIC_EXTINT11                     _UINT32_(11)
#define MUX_PA11A_EIC_EXTINT11                     _UINT32_(0) 
#define PINMUX_PA11A_EIC_EXTINT11                  ((PIN_PA11A_EIC_EXTINT11 << 16) | MUX_PA11A_EIC_EXTINT11)
#define PORT_PA11A_EIC_EXTINT11                    (_UINT32_(1) << 11)
#define PIN_PA11A_EIC_EXTINT_NUM                   _UINT32_(11) /* EIC signal: PIN_PA11 External Interrupt Line */

#define PIN_PA31A_EIC_EXTINT11                     _UINT32_(31)
#define MUX_PA31A_EIC_EXTINT11                     _UINT32_(0) 
#define PINMUX_PA31A_EIC_EXTINT11                  ((PIN_PA31A_EIC_EXTINT11 << 16) | MUX_PA31A_EIC_EXTINT11)
#define PORT_PA31A_EIC_EXTINT11                    (_UINT32_(1) << 31)
#define PIN_PA31A_EIC_EXTINT_NUM                   _UINT32_(11) /* EIC signal: PIN_PA31 External Interrupt Line */

#define PIN_PB11A_EIC_EXTINT11                     _UINT32_(43)
#define MUX_PB11A_EIC_EXTINT11                     _UINT32_(0) 
#define PINMUX_PB11A_EIC_EXTINT11                  ((PIN_PB11A_EIC_EXTINT11 << 16) | MUX_PB11A_EIC_EXTINT11)
#define PORT_PB11A_EIC_EXTINT11                    (_UINT32_(1) << 11)
#define PIN_PB11A_EIC_EXTINT_NUM                   _UINT32_(11) /* EIC signal: PIN_PB11 External Interrupt Line */

#define PIN_PA12A_EIC_EXTINT12                     _UINT32_(12)
#define MUX_PA12A_EIC_EXTINT12                     _UINT32_(0) 
#define PINMUX_PA12A_EIC_EXTINT12                  ((PIN_PA12A_EIC_EXTINT12 << 16) | MUX_PA12A_EIC_EXTINT12)
#define PORT_PA12A_EIC_EXTINT12                    (_UINT32_(1) << 12)
#define PIN_PA12A_EIC_EXTINT_NUM                   _UINT32_(12) /* EIC signal: PIN_PA12 External Interrupt Line */

#define PIN_PA24A_EIC_EXTINT12                     _UINT32_(24)
#define MUX_PA24A_EIC_EXTINT12                     _UINT32_(0) 
#define PINMUX_PA24A_EIC_EXTINT12                  ((PIN_PA24A_EIC_EXTINT12 << 16) | MUX_PA24A_EIC_EXTINT12)
#define PORT_PA24A_EIC_EXTINT12                    (_UINT32_(1) << 24)
#define PIN_PA24A_EIC_EXTINT_NUM                   _UINT32_(12) /* EIC signal: PIN_PA24 External Interrupt Line */

#define PIN_PA13A_EIC_EXTINT13                     _UINT32_(13)
#define MUX_PA13A_EIC_EXTINT13                     _UINT32_(0) 
#define PINMUX_PA13A_EIC_EXTINT13                  ((PIN_PA13A_EIC_EXTINT13 << 16) | MUX_PA13A_EIC_EXTINT13)
#define PORT_PA13A_EIC_EXTINT13                    (_UINT32_(1) << 13)
#define PIN_PA13A_EIC_EXTINT_NUM                   _UINT32_(13) /* EIC signal: PIN_PA13 External Interrupt Line */

#define PIN_PA25A_EIC_EXTINT13                     _UINT32_(25)
#define MUX_PA25A_EIC_EXTINT13                     _UINT32_(0) 
#define PINMUX_PA25A_EIC_EXTINT13                  ((PIN_PA25A_EIC_EXTINT13 << 16) | MUX_PA25A_EIC_EXTINT13)
#define PORT_PA25A_EIC_EXTINT13                    (_UINT32_(1) << 25)
#define PIN_PA25A_EIC_EXTINT_NUM                   _UINT32_(13) /* EIC signal: PIN_PA25 External Interrupt Line */

#define PIN_PA14A_EIC_EXTINT14                     _UINT32_(14)
#define MUX_PA14A_EIC_EXTINT14                     _UINT32_(0) 
#define PINMUX_PA14A_EIC_EXTINT14                  ((PIN_PA14A_EIC_EXTINT14 << 16) | MUX_PA14A_EIC_EXTINT14)
#define PORT_PA14A_EIC_EXTINT14                    (_UINT32_(1) << 14)
#define PIN_PA14A_EIC_EXTINT_NUM                   _UINT32_(14) /* EIC signal: PIN_PA14 External Interrupt Line */

#define PIN_PA15A_EIC_EXTINT15                     _UINT32_(15)
#define MUX_PA15A_EIC_EXTINT15                     _UINT32_(0) 
#define PINMUX_PA15A_EIC_EXTINT15                  ((PIN_PA15A_EIC_EXTINT15 << 16) | MUX_PA15A_EIC_EXTINT15)
#define PORT_PA15A_EIC_EXTINT15                    (_UINT32_(1) << 15)
#define PIN_PA15A_EIC_EXTINT_NUM                   _UINT32_(15) /* EIC signal: PIN_PA15 External Interrupt Line */

#define PIN_PA27A_EIC_EXTINT15                     _UINT32_(27)
#define MUX_PA27A_EIC_EXTINT15                     _UINT32_(0) 
#define PINMUX_PA27A_EIC_EXTINT15                  ((PIN_PA27A_EIC_EXTINT15 << 16) | MUX_PA27A_EIC_EXTINT15)
#define PORT_PA27A_EIC_EXTINT15                    (_UINT32_(1) << 27)
#define PIN_PA27A_EIC_EXTINT_NUM                   _UINT32_(15) /* EIC signal: PIN_PA27 External Interrupt Line */

#define PIN_PA08A_EIC_NMI                          _UINT32_(8) 
#define MUX_PA08A_EIC_NMI                          _UINT32_(0) 
#define PINMUX_PA08A_EIC_NMI                       ((PIN_PA08A_EIC_NMI << 16) | MUX_PA08A_EIC_NMI)
#define PORT_PA08A_EIC_NMI                         (_UINT32_(1) << 8)

/* ========== PORT definition for GCLK peripheral ========== */
#define PIN_PB22H_GCLK_IO0                         _UINT32_(54)
#define MUX_PB22H_GCLK_IO0                         _UINT32_(7) 
#define PINMUX_PB22H_GCLK_IO0                      ((PIN_PB22H_GCLK_IO0 << 16) | MUX_PB22H_GCLK_IO0)
#define PORT_PB22H_GCLK_IO0                        (_UINT32_(1) << 22)

#define PIN_PA14H_GCLK_IO0                         _UINT32_(14)
#define MUX_PA14H_GCLK_IO0                         _UINT32_(7) 
#define PINMUX_PA14H_GCLK_IO0                      ((PIN_PA14H_GCLK_IO0 << 16) | MUX_PA14H_GCLK_IO0)
#define PORT_PA14H_GCLK_IO0                        (_UINT32_(1) << 14)

#define PIN_PA27H_GCLK_IO0                         _UINT32_(27)
#define MUX_PA27H_GCLK_IO0                         _UINT32_(7) 
#define PINMUX_PA27H_GCLK_IO0                      ((PIN_PA27H_GCLK_IO0 << 16) | MUX_PA27H_GCLK_IO0)
#define PORT_PA27H_GCLK_IO0                        (_UINT32_(1) << 27)

#define PIN_PA28H_GCLK_IO0                         _UINT32_(28)
#define MUX_PA28H_GCLK_IO0                         _UINT32_(7) 
#define PINMUX_PA28H_GCLK_IO0                      ((PIN_PA28H_GCLK_IO0 << 16) | MUX_PA28H_GCLK_IO0)
#define PORT_PA28H_GCLK_IO0                        (_UINT32_(1) << 28)

#define PIN_PA30H_GCLK_IO0                         _UINT32_(30)
#define MUX_PA30H_GCLK_IO0                         _UINT32_(7) 
#define PINMUX_PA30H_GCLK_IO0                      ((PIN_PA30H_GCLK_IO0 << 16) | MUX_PA30H_GCLK_IO0)
#define PORT_PA30H_GCLK_IO0                        (_UINT32_(1) << 30)

#define PIN_PB23H_GCLK_IO1                         _UINT32_(55)
#define MUX_PB23H_GCLK_IO1                         _UINT32_(7) 
#define PINMUX_PB23H_GCLK_IO1                      ((PIN_PB23H_GCLK_IO1 << 16) | MUX_PB23H_GCLK_IO1)
#define PORT_PB23H_GCLK_IO1                        (_UINT32_(1) << 23)

#define PIN_PA15H_GCLK_IO1                         _UINT32_(15)
#define MUX_PA15H_GCLK_IO1                         _UINT32_(7) 
#define PINMUX_PA15H_GCLK_IO1                      ((PIN_PA15H_GCLK_IO1 << 16) | MUX_PA15H_GCLK_IO1)
#define PORT_PA15H_GCLK_IO1                        (_UINT32_(1) << 15)

#define PIN_PA16H_GCLK_IO2                         _UINT32_(16)
#define MUX_PA16H_GCLK_IO2                         _UINT32_(7) 
#define PINMUX_PA16H_GCLK_IO2                      ((PIN_PA16H_GCLK_IO2 << 16) | MUX_PA16H_GCLK_IO2)
#define PORT_PA16H_GCLK_IO2                        (_UINT32_(1) << 16)

#define PIN_PA17H_GCLK_IO3                         _UINT32_(17)
#define MUX_PA17H_GCLK_IO3                         _UINT32_(7) 
#define PINMUX_PA17H_GCLK_IO3                      ((PIN_PA17H_GCLK_IO3 << 16) | MUX_PA17H_GCLK_IO3)
#define PORT_PA17H_GCLK_IO3                        (_UINT32_(1) << 17)

#define PIN_PA10H_GCLK_IO4                         _UINT32_(10)
#define MUX_PA10H_GCLK_IO4                         _UINT32_(7) 
#define PINMUX_PA10H_GCLK_IO4                      ((PIN_PA10H_GCLK_IO4 << 16) | MUX_PA10H_GCLK_IO4)
#define PORT_PA10H_GCLK_IO4                        (_UINT32_(1) << 10)

#define PIN_PA20H_GCLK_IO4                         _UINT32_(20)
#define MUX_PA20H_GCLK_IO4                         _UINT32_(7) 
#define PINMUX_PA20H_GCLK_IO4                      ((PIN_PA20H_GCLK_IO4 << 16) | MUX_PA20H_GCLK_IO4)
#define PORT_PA20H_GCLK_IO4                        (_UINT32_(1) << 20)

#define PIN_PB10H_GCLK_IO4                         _UINT32_(42)
#define MUX_PB10H_GCLK_IO4                         _UINT32_(7) 
#define PINMUX_PB10H_GCLK_IO4                      ((PIN_PB10H_GCLK_IO4 << 16) | MUX_PB10H_GCLK_IO4)
#define PORT_PB10H_GCLK_IO4                        (_UINT32_(1) << 10)

#define PIN_PA11H_GCLK_IO5                         _UINT32_(11)
#define MUX_PA11H_GCLK_IO5                         _UINT32_(7) 
#define PINMUX_PA11H_GCLK_IO5                      ((PIN_PA11H_GCLK_IO5 << 16) | MUX_PA11H_GCLK_IO5)
#define PORT_PA11H_GCLK_IO5                        (_UINT32_(1) << 11)

#define PIN_PA21H_GCLK_IO5                         _UINT32_(21)
#define MUX_PA21H_GCLK_IO5                         _UINT32_(7) 
#define PINMUX_PA21H_GCLK_IO5                      ((PIN_PA21H_GCLK_IO5 << 16) | MUX_PA21H_GCLK_IO5)
#define PORT_PA21H_GCLK_IO5                        (_UINT32_(1) << 21)

#define PIN_PB11H_GCLK_IO5                         _UINT32_(43)
#define MUX_PB11H_GCLK_IO5                         _UINT32_(7) 
#define PINMUX_PB11H_GCLK_IO5                      ((PIN_PB11H_GCLK_IO5 << 16) | MUX_PB11H_GCLK_IO5)
#define PORT_PB11H_GCLK_IO5                        (_UINT32_(1) << 11)

#define PIN_PA22H_GCLK_IO6                         _UINT32_(22)
#define MUX_PA22H_GCLK_IO6                         _UINT32_(7) 
#define PINMUX_PA22H_GCLK_IO6                      ((PIN_PA22H_GCLK_IO6 << 16) | MUX_PA22H_GCLK_IO6)
#define PORT_PA22H_GCLK_IO6                        (_UINT32_(1) << 22)

#define PIN_PA23H_GCLK_IO7                         _UINT32_(23)
#define MUX_PA23H_GCLK_IO7                         _UINT32_(7) 
#define PINMUX_PA23H_GCLK_IO7                      ((PIN_PA23H_GCLK_IO7 << 16) | MUX_PA23H_GCLK_IO7)
#define PORT_PA23H_GCLK_IO7                        (_UINT32_(1) << 23)

/* ========== PORT definition for I2S peripheral ========== */
#define PIN_PA11G_I2S_FS0                          _UINT32_(11)
#define MUX_PA11G_I2S_FS0                          _UINT32_(6) 
#define PINMUX_PA11G_I2S_FS0                       ((PIN_PA11G_I2S_FS0 << 16) | MUX_PA11G_I2S_FS0)
#define PORT_PA11G_I2S_FS0                         (_UINT32_(1) << 11)

#define PIN_PA21G_I2S_FS0                          _UINT32_(21)
#define MUX_PA21G_I2S_FS0                          _UINT32_(6) 
#define PINMUX_PA21G_I2S_FS0                       ((PIN_PA21G_I2S_FS0 << 16) | MUX_PA21G_I2S_FS0)
#define PORT_PA21G_I2S_FS0                         (_UINT32_(1) << 21)

#define PIN_PA09G_I2S_MCK0                         _UINT32_(9) 
#define MUX_PA09G_I2S_MCK0                         _UINT32_(6) 
#define PINMUX_PA09G_I2S_MCK0                      ((PIN_PA09G_I2S_MCK0 << 16) | MUX_PA09G_I2S_MCK0)
#define PORT_PA09G_I2S_MCK0                        (_UINT32_(1) << 9)

#define PIN_PB10G_I2S_MCK1                         _UINT32_(42)
#define MUX_PB10G_I2S_MCK1                         _UINT32_(6) 
#define PINMUX_PB10G_I2S_MCK1                      ((PIN_PB10G_I2S_MCK1 << 16) | MUX_PB10G_I2S_MCK1)
#define PORT_PB10G_I2S_MCK1                        (_UINT32_(1) << 10)

#define PIN_PA10G_I2S_SCK0                         _UINT32_(10)
#define MUX_PA10G_I2S_SCK0                         _UINT32_(6) 
#define PINMUX_PA10G_I2S_SCK0                      ((PIN_PA10G_I2S_SCK0 << 16) | MUX_PA10G_I2S_SCK0)
#define PORT_PA10G_I2S_SCK0                        (_UINT32_(1) << 10)

#define PIN_PA20G_I2S_SCK0                         _UINT32_(20)
#define MUX_PA20G_I2S_SCK0                         _UINT32_(6) 
#define PINMUX_PA20G_I2S_SCK0                      ((PIN_PA20G_I2S_SCK0 << 16) | MUX_PA20G_I2S_SCK0)
#define PORT_PA20G_I2S_SCK0                        (_UINT32_(1) << 20)

#define PIN_PB11G_I2S_SCK1                         _UINT32_(43)
#define MUX_PB11G_I2S_SCK1                         _UINT32_(6) 
#define PINMUX_PB11G_I2S_SCK1                      ((PIN_PB11G_I2S_SCK1 << 16) | MUX_PB11G_I2S_SCK1)
#define PORT_PB11G_I2S_SCK1                        (_UINT32_(1) << 11)

#define PIN_PA07G_I2S_SD0                          _UINT32_(7) 
#define MUX_PA07G_I2S_SD0                          _UINT32_(6) 
#define PINMUX_PA07G_I2S_SD0                       ((PIN_PA07G_I2S_SD0 << 16) | MUX_PA07G_I2S_SD0)
#define PORT_PA07G_I2S_SD0                         (_UINT32_(1) << 7)

#define PIN_PA19G_I2S_SD0                          _UINT32_(19)
#define MUX_PA19G_I2S_SD0                          _UINT32_(6) 
#define PINMUX_PA19G_I2S_SD0                       ((PIN_PA19G_I2S_SD0 << 16) | MUX_PA19G_I2S_SD0)
#define PORT_PA19G_I2S_SD0                         (_UINT32_(1) << 19)

#define PIN_PA08G_I2S_SD1                          _UINT32_(8) 
#define MUX_PA08G_I2S_SD1                          _UINT32_(6) 
#define PINMUX_PA08G_I2S_SD1                       ((PIN_PA08G_I2S_SD1 << 16) | MUX_PA08G_I2S_SD1)
#define PORT_PA08G_I2S_SD1                         (_UINT32_(1) << 8)

/* ========== PORT definition for PTC peripheral ========== */
#define PIN_PA08B_PTC_X0                           _UINT32_(8) 
#define MUX_PA08B_PTC_X0                           _UINT32_(1) 
#define PINMUX_PA08B_PTC_X0                        ((PIN_PA08B_PTC_X0 << 16) | MUX_PA08B_PTC_X0)
#define PORT_PA08B_PTC_X0                          (_UINT32_(1) << 8)

#define PIN_PA09B_PTC_X1                           _UINT32_(9) 
#define MUX_PA09B_PTC_X1                           _UINT32_(1) 
#define PINMUX_PA09B_PTC_X1                        ((PIN_PA09B_PTC_X1 << 16) | MUX_PA09B_PTC_X1)
#define PORT_PA09B_PTC_X1                          (_UINT32_(1) << 9)

#define PIN_PA10B_PTC_X2                           _UINT32_(10)
#define MUX_PA10B_PTC_X2                           _UINT32_(1) 
#define PINMUX_PA10B_PTC_X2                        ((PIN_PA10B_PTC_X2 << 16) | MUX_PA10B_PTC_X2)
#define PORT_PA10B_PTC_X2                          (_UINT32_(1) << 10)

#define PIN_PA11B_PTC_X3                           _UINT32_(11)
#define MUX_PA11B_PTC_X3                           _UINT32_(1) 
#define PINMUX_PA11B_PTC_X3                        ((PIN_PA11B_PTC_X3 << 16) | MUX_PA11B_PTC_X3)
#define PORT_PA11B_PTC_X3                          (_UINT32_(1) << 11)

#define PIN_PA16B_PTC_X4                           _UINT32_(16)
#define MUX_PA16B_PTC_X4                           _UINT32_(1) 
#define PINMUX_PA16B_PTC_X4                        ((PIN_PA16B_PTC_X4 << 16) | MUX_PA16B_PTC_X4)
#define PORT_PA16B_PTC_X4                          (_UINT32_(1) << 16)

#define PIN_PA17B_PTC_X5                           _UINT32_(17)
#define MUX_PA17B_PTC_X5                           _UINT32_(1) 
#define PINMUX_PA17B_PTC_X5                        ((PIN_PA17B_PTC_X5 << 16) | MUX_PA17B_PTC_X5)
#define PORT_PA17B_PTC_X5                          (_UINT32_(1) << 17)

#define PIN_PA18B_PTC_X6                           _UINT32_(18)
#define MUX_PA18B_PTC_X6                           _UINT32_(1) 
#define PINMUX_PA18B_PTC_X6                        ((PIN_PA18B_PTC_X6 << 16) | MUX_PA18B_PTC_X6)
#define PORT_PA18B_PTC_X6                          (_UINT32_(1) << 18)

#define PIN_PA19B_PTC_X7                           _UINT32_(19)
#define MUX_PA19B_PTC_X7                           _UINT32_(1) 
#define PINMUX_PA19B_PTC_X7                        ((PIN_PA19B_PTC_X7 << 16) | MUX_PA19B_PTC_X7)
#define PORT_PA19B_PTC_X7                          (_UINT32_(1) << 19)

#define PIN_PA20B_PTC_X8                           _UINT32_(20)
#define MUX_PA20B_PTC_X8                           _UINT32_(1) 
#define PINMUX_PA20B_PTC_X8                        ((PIN_PA20B_PTC_X8 << 16) | MUX_PA20B_PTC_X8)
#define PORT_PA20B_PTC_X8                          (_UINT32_(1) << 20)

#define PIN_PA21B_PTC_X9                           _UINT32_(21)
#define MUX_PA21B_PTC_X9                           _UINT32_(1) 
#define PINMUX_PA21B_PTC_X9                        ((PIN_PA21B_PTC_X9 << 16) | MUX_PA21B_PTC_X9)
#define PORT_PA21B_PTC_X9                          (_UINT32_(1) << 21)

#define PIN_PA22B_PTC_X10                          _UINT32_(22)
#define MUX_PA22B_PTC_X10                          _UINT32_(1) 
#define PINMUX_PA22B_PTC_X10                       ((PIN_PA22B_PTC_X10 << 16) | MUX_PA22B_PTC_X10)
#define PORT_PA22B_PTC_X10                         (_UINT32_(1) << 22)

#define PIN_PA23B_PTC_X11                          _UINT32_(23)
#define MUX_PA23B_PTC_X11                          _UINT32_(1) 
#define PINMUX_PA23B_PTC_X11                       ((PIN_PA23B_PTC_X11 << 16) | MUX_PA23B_PTC_X11)
#define PORT_PA23B_PTC_X11                         (_UINT32_(1) << 23)

#define PIN_PA02B_PTC_Y0                           _UINT32_(2) 
#define MUX_PA02B_PTC_Y0                           _UINT32_(1) 
#define PINMUX_PA02B_PTC_Y0                        ((PIN_PA02B_PTC_Y0 << 16) | MUX_PA02B_PTC_Y0)
#define PORT_PA02B_PTC_Y0                          (_UINT32_(1) << 2)

#define PIN_PA03B_PTC_Y1                           _UINT32_(3) 
#define MUX_PA03B_PTC_Y1                           _UINT32_(1) 
#define PINMUX_PA03B_PTC_Y1                        ((PIN_PA03B_PTC_Y1 << 16) | MUX_PA03B_PTC_Y1)
#define PORT_PA03B_PTC_Y1                          (_UINT32_(1) << 3)

#define PIN_PA04B_PTC_Y2                           _UINT32_(4) 
#define MUX_PA04B_PTC_Y2                           _UINT32_(1) 
#define PINMUX_PA04B_PTC_Y2                        ((PIN_PA04B_PTC_Y2 << 16) | MUX_PA04B_PTC_Y2)
#define PORT_PA04B_PTC_Y2                          (_UINT32_(1) << 4)

#define PIN_PA05B_PTC_Y3                           _UINT32_(5) 
#define MUX_PA05B_PTC_Y3                           _UINT32_(1) 
#define PINMUX_PA05B_PTC_Y3                        ((PIN_PA05B_PTC_Y3 << 16) | MUX_PA05B_PTC_Y3)
#define PORT_PA05B_PTC_Y3                          (_UINT32_(1) << 5)

#define PIN_PA06B_PTC_Y4                           _UINT32_(6) 
#define MUX_PA06B_PTC_Y4                           _UINT32_(1) 
#define PINMUX_PA06B_PTC_Y4                        ((PIN_PA06B_PTC_Y4 << 16) | MUX_PA06B_PTC_Y4)
#define PORT_PA06B_PTC_Y4                          (_UINT32_(1) << 6)

#define PIN_PA07B_PTC_Y5                           _UINT32_(7) 
#define MUX_PA07B_PTC_Y5                           _UINT32_(1) 
#define PINMUX_PA07B_PTC_Y5                        ((PIN_PA07B_PTC_Y5 << 16) | MUX_PA07B_PTC_Y5)
#define PORT_PA07B_PTC_Y5                          (_UINT32_(1) << 7)

#define PIN_PB02B_PTC_Y8                           _UINT32_(34)
#define MUX_PB02B_PTC_Y8                           _UINT32_(1) 
#define PINMUX_PB02B_PTC_Y8                        ((PIN_PB02B_PTC_Y8 << 16) | MUX_PB02B_PTC_Y8)
#define PORT_PB02B_PTC_Y8                          (_UINT32_(1) << 2)

#define PIN_PB03B_PTC_Y9                           _UINT32_(35)
#define MUX_PB03B_PTC_Y9                           _UINT32_(1) 
#define PINMUX_PB03B_PTC_Y9                        ((PIN_PB03B_PTC_Y9 << 16) | MUX_PB03B_PTC_Y9)
#define PORT_PB03B_PTC_Y9                          (_UINT32_(1) << 3)

#define PIN_PB08B_PTC_Y14                          _UINT32_(40)
#define MUX_PB08B_PTC_Y14                          _UINT32_(1) 
#define PINMUX_PB08B_PTC_Y14                       ((PIN_PB08B_PTC_Y14 << 16) | MUX_PB08B_PTC_Y14)
#define PORT_PB08B_PTC_Y14                         (_UINT32_(1) << 8)

#define PIN_PB09B_PTC_Y15                          _UINT32_(41)
#define MUX_PB09B_PTC_Y15                          _UINT32_(1) 
#define PINMUX_PB09B_PTC_Y15                       ((PIN_PB09B_PTC_Y15 << 16) | MUX_PB09B_PTC_Y15)
#define PORT_PB09B_PTC_Y15                         (_UINT32_(1) << 9)

/* ========== PORT definition for SERCOM0 peripheral ========== */
#define PIN_PA04D_SERCOM0_PAD0                     _UINT32_(4) 
#define MUX_PA04D_SERCOM0_PAD0                     _UINT32_(3) 
#define PINMUX_PA04D_SERCOM0_PAD0                  ((PIN_PA04D_SERCOM0_PAD0 << 16) | MUX_PA04D_SERCOM0_PAD0)
#define PORT_PA04D_SERCOM0_PAD0                    (_UINT32_(1) << 4)

#define PIN_PA08C_SERCOM0_PAD0                     _UINT32_(8) 
#define MUX_PA08C_SERCOM0_PAD0                     _UINT32_(2) 
#define PINMUX_PA08C_SERCOM0_PAD0                  ((PIN_PA08C_SERCOM0_PAD0 << 16) | MUX_PA08C_SERCOM0_PAD0)
#define PORT_PA08C_SERCOM0_PAD0                    (_UINT32_(1) << 8)

#define PIN_PA05D_SERCOM0_PAD1                     _UINT32_(5) 
#define MUX_PA05D_SERCOM0_PAD1                     _UINT32_(3) 
#define PINMUX_PA05D_SERCOM0_PAD1                  ((PIN_PA05D_SERCOM0_PAD1 << 16) | MUX_PA05D_SERCOM0_PAD1)
#define PORT_PA05D_SERCOM0_PAD1                    (_UINT32_(1) << 5)

#define PIN_PA09C_SERCOM0_PAD1                     _UINT32_(9) 
#define MUX_PA09C_SERCOM0_PAD1                     _UINT32_(2) 
#define PINMUX_PA09C_SERCOM0_PAD1                  ((PIN_PA09C_SERCOM0_PAD1 << 16) | MUX_PA09C_SERCOM0_PAD1)
#define PORT_PA09C_SERCOM0_PAD1                    (_UINT32_(1) << 9)

#define PIN_PA06D_SERCOM0_PAD2                     _UINT32_(6) 
#define MUX_PA06D_SERCOM0_PAD2                     _UINT32_(3) 
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
#define MUX_PA17D_SERCOM3_PAD1                     _UINT32_(3) 
#define PINMUX_PA17D_SERCOM3_PAD1                  ((PIN_PA17D_SERCOM3_PAD1 << 16) | MUX_PA17D_SERCOM3_PAD1)
#define PORT_PA17D_SERCOM3_PAD1                    (_UINT32_(1) << 17)

#define PIN_PA23C_SERCOM3_PAD1                     _UINT32_(23)
#define MUX_PA23C_SERCOM3_PAD1                     _UINT32_(2) 
#define PINMUX_PA23C_SERCOM3_PAD1                  ((PIN_PA23C_SERCOM3_PAD1 << 16) | MUX_PA23C_SERCOM3_PAD1)
#define PORT_PA23C_SERCOM3_PAD1                    (_UINT32_(1) << 23)

#define PIN_PA18D_SERCOM3_PAD2                     _UINT32_(18)
#define MUX_PA18D_SERCOM3_PAD2                     _UINT32_(3) 
#define PINMUX_PA18D_SERCOM3_PAD2                  ((PIN_PA18D_SERCOM3_PAD2 << 16) | MUX_PA18D_SERCOM3_PAD2)
#define PORT_PA18D_SERCOM3_PAD2                    (_UINT32_(1) << 18)

#define PIN_PA20D_SERCOM3_PAD2                     _UINT32_(20)
#define MUX_PA20D_SERCOM3_PAD2                     _UINT32_(3) 
#define PINMUX_PA20D_SERCOM3_PAD2                  ((PIN_PA20D_SERCOM3_PAD2 << 16) | MUX_PA20D_SERCOM3_PAD2)
#define PORT_PA20D_SERCOM3_PAD2                    (_UINT32_(1) << 20)

#define PIN_PA24C_SERCOM3_PAD2                     _UINT32_(24)
#define MUX_PA24C_SERCOM3_PAD2                     _UINT32_(2) 
#define PINMUX_PA24C_SERCOM3_PAD2                  ((PIN_PA24C_SERCOM3_PAD2 << 16) | MUX_PA24C_SERCOM3_PAD2)
#define PORT_PA24C_SERCOM3_PAD2                    (_UINT32_(1) << 24)

#define PIN_PA19D_SERCOM3_PAD3                     _UINT32_(19)
#define MUX_PA19D_SERCOM3_PAD3                     _UINT32_(3) 
#define PINMUX_PA19D_SERCOM3_PAD3                  ((PIN_PA19D_SERCOM3_PAD3 << 16) | MUX_PA19D_SERCOM3_PAD3)
#define PORT_PA19D_SERCOM3_PAD3                    (_UINT32_(1) << 19)

#define PIN_PA21D_SERCOM3_PAD3                     _UINT32_(21)
#define MUX_PA21D_SERCOM3_PAD3                     _UINT32_(3) 
#define PINMUX_PA21D_SERCOM3_PAD3                  ((PIN_PA21D_SERCOM3_PAD3 << 16) | MUX_PA21D_SERCOM3_PAD3)
#define PORT_PA21D_SERCOM3_PAD3                    (_UINT32_(1) << 21)

#define PIN_PA25C_SERCOM3_PAD3                     _UINT32_(25)
#define MUX_PA25C_SERCOM3_PAD3                     _UINT32_(2) 
#define PINMUX_PA25C_SERCOM3_PAD3                  ((PIN_PA25C_SERCOM3_PAD3 << 16) | MUX_PA25C_SERCOM3_PAD3)
#define PORT_PA25C_SERCOM3_PAD3                    (_UINT32_(1) << 25)

/* ========== PORT definition for SERCOM4 peripheral ========== */
#define PIN_PA12D_SERCOM4_PAD0                     _UINT32_(12)
#define MUX_PA12D_SERCOM4_PAD0                     _UINT32_(3) 
#define PINMUX_PA12D_SERCOM4_PAD0                  ((PIN_PA12D_SERCOM4_PAD0 << 16) | MUX_PA12D_SERCOM4_PAD0)
#define PORT_PA12D_SERCOM4_PAD0                    (_UINT32_(1) << 12)

#define PIN_PB08D_SERCOM4_PAD0                     _UINT32_(40)
#define MUX_PB08D_SERCOM4_PAD0                     _UINT32_(3) 
#define PINMUX_PB08D_SERCOM4_PAD0                  ((PIN_PB08D_SERCOM4_PAD0 << 16) | MUX_PB08D_SERCOM4_PAD0)
#define PORT_PB08D_SERCOM4_PAD0                    (_UINT32_(1) << 8)

#define PIN_PA13D_SERCOM4_PAD1                     _UINT32_(13)
#define MUX_PA13D_SERCOM4_PAD1                     _UINT32_(3) 
#define PINMUX_PA13D_SERCOM4_PAD1                  ((PIN_PA13D_SERCOM4_PAD1 << 16) | MUX_PA13D_SERCOM4_PAD1)
#define PORT_PA13D_SERCOM4_PAD1                    (_UINT32_(1) << 13)

#define PIN_PB09D_SERCOM4_PAD1                     _UINT32_(41)
#define MUX_PB09D_SERCOM4_PAD1                     _UINT32_(3) 
#define PINMUX_PB09D_SERCOM4_PAD1                  ((PIN_PB09D_SERCOM4_PAD1 << 16) | MUX_PB09D_SERCOM4_PAD1)
#define PORT_PB09D_SERCOM4_PAD1                    (_UINT32_(1) << 9)

#define PIN_PA14D_SERCOM4_PAD2                     _UINT32_(14)
#define MUX_PA14D_SERCOM4_PAD2                     _UINT32_(3) 
#define PINMUX_PA14D_SERCOM4_PAD2                  ((PIN_PA14D_SERCOM4_PAD2 << 16) | MUX_PA14D_SERCOM4_PAD2)
#define PORT_PA14D_SERCOM4_PAD2                    (_UINT32_(1) << 14)

#define PIN_PB10D_SERCOM4_PAD2                     _UINT32_(42)
#define MUX_PB10D_SERCOM4_PAD2                     _UINT32_(3) 
#define PINMUX_PB10D_SERCOM4_PAD2                  ((PIN_PB10D_SERCOM4_PAD2 << 16) | MUX_PB10D_SERCOM4_PAD2)
#define PORT_PB10D_SERCOM4_PAD2                    (_UINT32_(1) << 10)

#define PIN_PA15D_SERCOM4_PAD3                     _UINT32_(15)
#define MUX_PA15D_SERCOM4_PAD3                     _UINT32_(3) 
#define PINMUX_PA15D_SERCOM4_PAD3                  ((PIN_PA15D_SERCOM4_PAD3 << 16) | MUX_PA15D_SERCOM4_PAD3)
#define PORT_PA15D_SERCOM4_PAD3                    (_UINT32_(1) << 15)

#define PIN_PB11D_SERCOM4_PAD3                     _UINT32_(43)
#define MUX_PB11D_SERCOM4_PAD3                     _UINT32_(3) 
#define PINMUX_PB11D_SERCOM4_PAD3                  ((PIN_PB11D_SERCOM4_PAD3 << 16) | MUX_PB11D_SERCOM4_PAD3)
#define PORT_PB11D_SERCOM4_PAD3                    (_UINT32_(1) << 11)

/* ========== PORT definition for SERCOM5 peripheral ========== */
#define PIN_PA22D_SERCOM5_PAD0                     _UINT32_(22)
#define MUX_PA22D_SERCOM5_PAD0                     _UINT32_(3) 
#define PINMUX_PA22D_SERCOM5_PAD0                  ((PIN_PA22D_SERCOM5_PAD0 << 16) | MUX_PA22D_SERCOM5_PAD0)
#define PORT_PA22D_SERCOM5_PAD0                    (_UINT32_(1) << 22)

#define PIN_PB02D_SERCOM5_PAD0                     _UINT32_(34)
#define MUX_PB02D_SERCOM5_PAD0                     _UINT32_(3) 
#define PINMUX_PB02D_SERCOM5_PAD0                  ((PIN_PB02D_SERCOM5_PAD0 << 16) | MUX_PB02D_SERCOM5_PAD0)
#define PORT_PB02D_SERCOM5_PAD0                    (_UINT32_(1) << 2)

#define PIN_PA23D_SERCOM5_PAD1                     _UINT32_(23)
#define MUX_PA23D_SERCOM5_PAD1                     _UINT32_(3) 
#define PINMUX_PA23D_SERCOM5_PAD1                  ((PIN_PA23D_SERCOM5_PAD1 << 16) | MUX_PA23D_SERCOM5_PAD1)
#define PORT_PA23D_SERCOM5_PAD1                    (_UINT32_(1) << 23)

#define PIN_PB03D_SERCOM5_PAD1                     _UINT32_(35)
#define MUX_PB03D_SERCOM5_PAD1                     _UINT32_(3) 
#define PINMUX_PB03D_SERCOM5_PAD1                  ((PIN_PB03D_SERCOM5_PAD1 << 16) | MUX_PB03D_SERCOM5_PAD1)
#define PORT_PB03D_SERCOM5_PAD1                    (_UINT32_(1) << 3)

#define PIN_PA24D_SERCOM5_PAD2                     _UINT32_(24)
#define MUX_PA24D_SERCOM5_PAD2                     _UINT32_(3) 
#define PINMUX_PA24D_SERCOM5_PAD2                  ((PIN_PA24D_SERCOM5_PAD2 << 16) | MUX_PA24D_SERCOM5_PAD2)
#define PORT_PA24D_SERCOM5_PAD2                    (_UINT32_(1) << 24)

#define PIN_PB22D_SERCOM5_PAD2                     _UINT32_(54)
#define MUX_PB22D_SERCOM5_PAD2                     _UINT32_(3) 
#define PINMUX_PB22D_SERCOM5_PAD2                  ((PIN_PB22D_SERCOM5_PAD2 << 16) | MUX_PB22D_SERCOM5_PAD2)
#define PORT_PB22D_SERCOM5_PAD2                    (_UINT32_(1) << 22)

#define PIN_PA20C_SERCOM5_PAD2                     _UINT32_(20)
#define MUX_PA20C_SERCOM5_PAD2                     _UINT32_(2) 
#define PINMUX_PA20C_SERCOM5_PAD2                  ((PIN_PA20C_SERCOM5_PAD2 << 16) | MUX_PA20C_SERCOM5_PAD2)
#define PORT_PA20C_SERCOM5_PAD2                    (_UINT32_(1) << 20)

#define PIN_PA25D_SERCOM5_PAD3                     _UINT32_(25)
#define MUX_PA25D_SERCOM5_PAD3                     _UINT32_(3) 
#define PINMUX_PA25D_SERCOM5_PAD3                  ((PIN_PA25D_SERCOM5_PAD3 << 16) | MUX_PA25D_SERCOM5_PAD3)
#define PORT_PA25D_SERCOM5_PAD3                    (_UINT32_(1) << 25)

#define PIN_PB23D_SERCOM5_PAD3                     _UINT32_(55)
#define MUX_PB23D_SERCOM5_PAD3                     _UINT32_(3) 
#define PINMUX_PB23D_SERCOM5_PAD3                  ((PIN_PB23D_SERCOM5_PAD3 << 16) | MUX_PB23D_SERCOM5_PAD3)
#define PORT_PB23D_SERCOM5_PAD3                    (_UINT32_(1) << 23)

#define PIN_PA21C_SERCOM5_PAD3                     _UINT32_(21)
#define MUX_PA21C_SERCOM5_PAD3                     _UINT32_(2) 
#define PINMUX_PA21C_SERCOM5_PAD3                  ((PIN_PA21C_SERCOM5_PAD3 << 16) | MUX_PA21C_SERCOM5_PAD3)
#define PORT_PA21C_SERCOM5_PAD3                    (_UINT32_(1) << 21)

/* ========== PORT definition for TC3 peripheral ========== */
#define PIN_PA18E_TC3_WO0                          _UINT32_(18)
#define MUX_PA18E_TC3_WO0                          _UINT32_(4) 
#define PINMUX_PA18E_TC3_WO0                       ((PIN_PA18E_TC3_WO0 << 16) | MUX_PA18E_TC3_WO0)
#define PORT_PA18E_TC3_WO0                         (_UINT32_(1) << 18)

#define PIN_PA14E_TC3_WO0                          _UINT32_(14)
#define MUX_PA14E_TC3_WO0                          _UINT32_(4) 
#define PINMUX_PA14E_TC3_WO0                       ((PIN_PA14E_TC3_WO0 << 16) | MUX_PA14E_TC3_WO0)
#define PORT_PA14E_TC3_WO0                         (_UINT32_(1) << 14)

#define PIN_PA19E_TC3_WO1                          _UINT32_(19)
#define MUX_PA19E_TC3_WO1                          _UINT32_(4) 
#define PINMUX_PA19E_TC3_WO1                       ((PIN_PA19E_TC3_WO1 << 16) | MUX_PA19E_TC3_WO1)
#define PORT_PA19E_TC3_WO1                         (_UINT32_(1) << 19)

#define PIN_PA15E_TC3_WO1                          _UINT32_(15)
#define MUX_PA15E_TC3_WO1                          _UINT32_(4) 
#define PINMUX_PA15E_TC3_WO1                       ((PIN_PA15E_TC3_WO1 << 16) | MUX_PA15E_TC3_WO1)
#define PORT_PA15E_TC3_WO1                         (_UINT32_(1) << 15)

/* ========== PORT definition for TC4 peripheral ========== */
#define PIN_PA22E_TC4_WO0                          _UINT32_(22)
#define MUX_PA22E_TC4_WO0                          _UINT32_(4) 
#define PINMUX_PA22E_TC4_WO0                       ((PIN_PA22E_TC4_WO0 << 16) | MUX_PA22E_TC4_WO0)
#define PORT_PA22E_TC4_WO0                         (_UINT32_(1) << 22)

#define PIN_PB08E_TC4_WO0                          _UINT32_(40)
#define MUX_PB08E_TC4_WO0                          _UINT32_(4) 
#define PINMUX_PB08E_TC4_WO0                       ((PIN_PB08E_TC4_WO0 << 16) | MUX_PB08E_TC4_WO0)
#define PORT_PB08E_TC4_WO0                         (_UINT32_(1) << 8)

#define PIN_PA23E_TC4_WO1                          _UINT32_(23)
#define MUX_PA23E_TC4_WO1                          _UINT32_(4) 
#define PINMUX_PA23E_TC4_WO1                       ((PIN_PA23E_TC4_WO1 << 16) | MUX_PA23E_TC4_WO1)
#define PORT_PA23E_TC4_WO1                         (_UINT32_(1) << 23)

#define PIN_PB09E_TC4_WO1                          _UINT32_(41)
#define MUX_PB09E_TC4_WO1                          _UINT32_(4) 
#define PINMUX_PB09E_TC4_WO1                       ((PIN_PB09E_TC4_WO1 << 16) | MUX_PB09E_TC4_WO1)
#define PORT_PB09E_TC4_WO1                         (_UINT32_(1) << 9)

/* ========== PORT definition for TC5 peripheral ========== */
#define PIN_PA24E_TC5_WO0                          _UINT32_(24)
#define MUX_PA24E_TC5_WO0                          _UINT32_(4) 
#define PINMUX_PA24E_TC5_WO0                       ((PIN_PA24E_TC5_WO0 << 16) | MUX_PA24E_TC5_WO0)
#define PORT_PA24E_TC5_WO0                         (_UINT32_(1) << 24)

#define PIN_PB10E_TC5_WO0                          _UINT32_(42)
#define MUX_PB10E_TC5_WO0                          _UINT32_(4) 
#define PINMUX_PB10E_TC5_WO0                       ((PIN_PB10E_TC5_WO0 << 16) | MUX_PB10E_TC5_WO0)
#define PORT_PB10E_TC5_WO0                         (_UINT32_(1) << 10)

#define PIN_PA25E_TC5_WO1                          _UINT32_(25)
#define MUX_PA25E_TC5_WO1                          _UINT32_(4) 
#define PINMUX_PA25E_TC5_WO1                       ((PIN_PA25E_TC5_WO1 << 16) | MUX_PA25E_TC5_WO1)
#define PORT_PA25E_TC5_WO1                         (_UINT32_(1) << 25)

#define PIN_PB11E_TC5_WO1                          _UINT32_(43)
#define MUX_PB11E_TC5_WO1                          _UINT32_(4) 
#define PINMUX_PB11E_TC5_WO1                       ((PIN_PB11E_TC5_WO1 << 16) | MUX_PB11E_TC5_WO1)
#define PORT_PB11E_TC5_WO1                         (_UINT32_(1) << 11)

/* ========== PORT definition for TCC0 peripheral ========== */
#define PIN_PA04E_TCC0_WO0                         _UINT32_(4) 
#define MUX_PA04E_TCC0_WO0                         _UINT32_(4) 
#define PINMUX_PA04E_TCC0_WO0                      ((PIN_PA04E_TCC0_WO0 << 16) | MUX_PA04E_TCC0_WO0)
#define PORT_PA04E_TCC0_WO0                        (_UINT32_(1) << 4)

#define PIN_PA08E_TCC0_WO0                         _UINT32_(8) 
#define MUX_PA08E_TCC0_WO0                         _UINT32_(4) 
#define PINMUX_PA08E_TCC0_WO0                      ((PIN_PA08E_TCC0_WO0 << 16) | MUX_PA08E_TCC0_WO0)
#define PORT_PA08E_TCC0_WO0                        (_UINT32_(1) << 8)

#define PIN_PA05E_TCC0_WO1                         _UINT32_(5) 
#define MUX_PA05E_TCC0_WO1                         _UINT32_(4) 
#define PINMUX_PA05E_TCC0_WO1                      ((PIN_PA05E_TCC0_WO1 << 16) | MUX_PA05E_TCC0_WO1)
#define PORT_PA05E_TCC0_WO1                        (_UINT32_(1) << 5)

#define PIN_PA09E_TCC0_WO1                         _UINT32_(9) 
#define MUX_PA09E_TCC0_WO1                         _UINT32_(4) 
#define PINMUX_PA09E_TCC0_WO1                      ((PIN_PA09E_TCC0_WO1 << 16) | MUX_PA09E_TCC0_WO1)
#define PORT_PA09E_TCC0_WO1                        (_UINT32_(1) << 9)

#define PIN_PA10F_TCC0_WO2                         _UINT32_(10)
#define MUX_PA10F_TCC0_WO2                         _UINT32_(5) 
#define PINMUX_PA10F_TCC0_WO2                      ((PIN_PA10F_TCC0_WO2 << 16) | MUX_PA10F_TCC0_WO2)
#define PORT_PA10F_TCC0_WO2                        (_UINT32_(1) << 10)

#define PIN_PA18F_TCC0_WO2                         _UINT32_(18)
#define MUX_PA18F_TCC0_WO2                         _UINT32_(5) 
#define PINMUX_PA18F_TCC0_WO2                      ((PIN_PA18F_TCC0_WO2 << 16) | MUX_PA18F_TCC0_WO2)
#define PORT_PA18F_TCC0_WO2                        (_UINT32_(1) << 18)

#define PIN_PA11F_TCC0_WO3                         _UINT32_(11)
#define MUX_PA11F_TCC0_WO3                         _UINT32_(5) 
#define PINMUX_PA11F_TCC0_WO3                      ((PIN_PA11F_TCC0_WO3 << 16) | MUX_PA11F_TCC0_WO3)
#define PORT_PA11F_TCC0_WO3                        (_UINT32_(1) << 11)

#define PIN_PA19F_TCC0_WO3                         _UINT32_(19)
#define MUX_PA19F_TCC0_WO3                         _UINT32_(5) 
#define PINMUX_PA19F_TCC0_WO3                      ((PIN_PA19F_TCC0_WO3 << 16) | MUX_PA19F_TCC0_WO3)
#define PORT_PA19F_TCC0_WO3                        (_UINT32_(1) << 19)

#define PIN_PA14F_TCC0_WO4                         _UINT32_(14)
#define MUX_PA14F_TCC0_WO4                         _UINT32_(5) 
#define PINMUX_PA14F_TCC0_WO4                      ((PIN_PA14F_TCC0_WO4 << 16) | MUX_PA14F_TCC0_WO4)
#define PORT_PA14F_TCC0_WO4                        (_UINT32_(1) << 14)

#define PIN_PA22F_TCC0_WO4                         _UINT32_(22)
#define MUX_PA22F_TCC0_WO4                         _UINT32_(5) 
#define PINMUX_PA22F_TCC0_WO4                      ((PIN_PA22F_TCC0_WO4 << 16) | MUX_PA22F_TCC0_WO4)
#define PORT_PA22F_TCC0_WO4                        (_UINT32_(1) << 22)

#define PIN_PB10F_TCC0_WO4                         _UINT32_(42)
#define MUX_PB10F_TCC0_WO4                         _UINT32_(5) 
#define PINMUX_PB10F_TCC0_WO4                      ((PIN_PB10F_TCC0_WO4 << 16) | MUX_PB10F_TCC0_WO4)
#define PORT_PB10F_TCC0_WO4                        (_UINT32_(1) << 10)

#define PIN_PA15F_TCC0_WO5                         _UINT32_(15)
#define MUX_PA15F_TCC0_WO5                         _UINT32_(5) 
#define PINMUX_PA15F_TCC0_WO5                      ((PIN_PA15F_TCC0_WO5 << 16) | MUX_PA15F_TCC0_WO5)
#define PORT_PA15F_TCC0_WO5                        (_UINT32_(1) << 15)

#define PIN_PA23F_TCC0_WO5                         _UINT32_(23)
#define MUX_PA23F_TCC0_WO5                         _UINT32_(5) 
#define PINMUX_PA23F_TCC0_WO5                      ((PIN_PA23F_TCC0_WO5 << 16) | MUX_PA23F_TCC0_WO5)
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
#define MUX_PA17E_TCC2_WO1                         _UINT32_(4) 
#define PINMUX_PA17E_TCC2_WO1                      ((PIN_PA17E_TCC2_WO1 << 16) | MUX_PA17E_TCC2_WO1)
#define PORT_PA17E_TCC2_WO1                        (_UINT32_(1) << 17)

#define PIN_PA01E_TCC2_WO1                         _UINT32_(1) 
#define MUX_PA01E_TCC2_WO1                         _UINT32_(4) 
#define PINMUX_PA01E_TCC2_WO1                      ((PIN_PA01E_TCC2_WO1 << 16) | MUX_PA01E_TCC2_WO1)
#define PORT_PA01E_TCC2_WO1                        (_UINT32_(1) << 1)

/* ========== PORT definition for USB peripheral ========== */
#define PIN_PA24G_USB_DM                           _UINT32_(24)
#define MUX_PA24G_USB_DM                           _UINT32_(6) 
#define PINMUX_PA24G_USB_DM                        ((PIN_PA24G_USB_DM << 16) | MUX_PA24G_USB_DM)
#define PORT_PA24G_USB_DM                          (_UINT32_(1) << 24)

#define PIN_PA25G_USB_DP                           _UINT32_(25)
#define MUX_PA25G_USB_DP                           _UINT32_(6) 
#define PINMUX_PA25G_USB_DP                        ((PIN_PA25G_USB_DP << 16) | MUX_PA25G_USB_DP)
#define PORT_PA25G_USB_DP                          (_UINT32_(1) << 25)

#define PIN_PA23G_USB_SOF_1KHZ                     _UINT32_(23)
#define MUX_PA23G_USB_SOF_1KHZ                     _UINT32_(6) 
#define PINMUX_PA23G_USB_SOF_1KHZ                  ((PIN_PA23G_USB_SOF_1KHZ << 16) | MUX_PA23G_USB_SOF_1KHZ)
#define PORT_PA23G_USB_SOF_1KHZ                    (_UINT32_(1) << 23)



#endif /* _SAMD21G18A_GPIO_H_ */
