jelkinsjames/chameleon-PCB/(commit log)

2023-02-12 Add files via upload
    Some progress was made on the PCB and schematic should be finished. Everything is placed, now I need to route and make the ground pours.
    [IC_ADS125H01IRHBT.step, PCM5242.kicad_pcb, PCM5242.kicad_sch]
2023-02-12 adding 1863 V2
    [PCM1863-B_Cu.gbr, PCM1863-B_Mask.gbr, PCM1863-B_Paste.gbr, PCM1863-B_Silkscreen.gbr, PCM1863-Edge_Cuts.gbr, PCM1863-F_Cu.gbr, PCM1863-F_Mask.gbr, PCM1863-F_Paste.gbr]
2023-02-14 Update PCB
    Almost finished routing and pouring, I have several questions for the meeting tomorrow luckily!
    [IC_ADS125H01IRHBT.step, PCM5242.kicad_pcb, PCM5242.kicad_sch]
2023-02-14 Updated PCB
    Almost finished routing and pouring, I have some design questions for tomorrow.
    [PCM5242.kicad_pcb]
2023-02-14 Delete PCM5242 directory
    Accidentally made this.
    [IC_ADS125H01IRHBT.step, PCM5242.kicad_pcb, PCM5242.kicad_sch]
2023-02-15 tutorial part added
    [STM32tut.kicad_pcb, STM32tut.kicad_sch]
2023-02-15 finished tut
    [629105150521 (rev1).stp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]
2023-02-15 1863 power added and schematic updated
    [PCM1863.kicad_sch]
2023-02-15 PCB placement no trace
    [PCM1863.kicad_pcb, PCM1863.kicad_sch]
2023-02-16 adc v3 complete
    [PCM1863.csv, PCM1863.kicad_pcb, PCM1863.kicad_sch]
2023-02-16 fix typo in adc
    [PCM1863.kicad_pcb]
2023-02-16 fix analog too close to digital
    [PCM1863.kicad_pcb, PCM1863.kicad_sch]
2023-02-17 added jumpers
    [PCM1863.kicad_sch]
2023-02-17 IOBoard Added
    [IO Board.kicad_pcb, IO Board.kicad_sch]
2023-02-17 schematic updates for ADC
    [PCM1863-B_Cu.gbr, PCM1863-B_Mask.gbr, PCM1863-B_Paste.gbr, PCM1863-B_Silkscreen.gbr, PCM1863-Edge_Cuts.gbr, PCM1863-F_Cu.gbr, PCM1863-F_Mask.gbr, PCM1863-F_Paste.gbr]
2023-02-17 pcb grouping
    [PCM1863.csv, PCM1863.kicad_pcb, PCM1863.kicad_sch]
2023-02-20 finished ADC v.4
    [PCM1863.kicad_pcb]
2023-02-21 IO Board PCB updated
    [IO Board.kicad_pcb, IO Board.kicad_sch]
2023-02-21 adc update
    [PCM1863-B_Cu.gbr, PCM1863-B_Mask.gbr, PCM1863-B_Paste.gbr, PCM1863-B_Silkscreen.gbr, PCM1863-Edge_Cuts.gbr, PCM1863-F_Cu.gbr, PCM1863-F_Mask.gbr, PCM1863-F_Paste.gbr]
2023-02-22 updating readme
    [PCM1863-B_Cu.gbr, PCM1863-B_Mask.gbr, PCM1863-B_Paste.gbr, PCM1863-B_Silkscreen.gbr, PCM1863-Edge_Cuts.gbr, PCM1863-F_Cu.gbr, PCM1863-F_Mask.gbr, PCM1863-F_Paste.gbr]
2023-02-25 misc updates
    [PCM1863-v3.csv, PCM1863.csv]
2023-02-25 DIX Board Start (Max Version)
    Just a start here....
    [DIX_Board.kicad_pcb, DIX_Board.kicad_sch]
2023-02-27 IOBoard PCB v1
    [IO Board.kicad_pcb, IO Board.kicad_sch]
2023-02-28 Max Version of DIX board
    [DIX_Board.kicad_pcb, DIX_Board.kicad_sch]
2023-02-28 IOBoard ATSAMD21 V1 added
    [IOBoard_ATSAMD21-B_Cu.gbr, IOBoard_ATSAMD21-B_Mask.gbr, IOBoard_ATSAMD21-B_Paste.gbr, IOBoard_ATSAMD21-B_Silkscreen.gbr, IOBoard_ATSAMD21-Edge_Cuts.gbr, IOBoard_ATSAMD21-F_Cu.gbr, IOBoard_ATSAMD21-F_Mask.gbr, IOBoard_ATSAMD21-F_Paste.gbr]
2023-02-28 More! Stuff!
    Started on the actual board. Lots to learn.
    [DIX_Board.kicad_pcb, DIX_Board.kicad_sch]
2023-02-28 Less electrical check failures
    [DIX_Board.kicad_pcb, DIX_Board.kicad_sch]
2023-03-01 IO Board Silkscreening Finished
    [IOBoard_ATSAMD21-B_Cu.gbr, IOBoard_ATSAMD21-B_Mask.gbr, IOBoard_ATSAMD21-B_Paste.gbr, IOBoard_ATSAMD21-B_Silkscreen.gbr, IOBoard_ATSAMD21-Edge_Cuts.gbr, IOBoard_ATSAMD21-F_Cu.gbr, IOBoard_ATSAMD21-F_Mask.gbr, IOBoard_ATSAMD21-F_Paste.gbr]
2023-03-06 Some routing
    [DIX_Board.kicad_pcb, DIX_Board.kicad_sch]
2023-03-07 Uploaded new 5242
    Realized my 5242 was out of date, uploaded new folder
    [IC_ADS125H01IRHBT.step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]
2023-03-07 Delete Old 5242 Folder
    No longer needed
    [IC_ADS125H01IRHBT.step, PCM5242.kicad_pcb, PCM5242.kicad_sch]
2023-03-09 updating lab PC
    [IOBoard_ATSAMD21.kicad_pcb]
2023-03-12 schematic v5
    [PCM1863.kicad_pcb, PCM1863.kicad_sch]
2023-03-12 v5 finished
    [PCM1863.kicad_pcb, PCM1863.kicad_sch]
2023-03-17 adc v5
    [IOBoard_ATSAMD21.kicad_pcb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]
2023-03-27 adc setup guide
    [PCM1863.kicad_pcb]
2023-03-30 Transmitter board V 1.01
    [Transmitter.kicad_pcb, Transmitter.kicad_sch]
2023-03-30 DAC 3.0 V1
    [PCM5242.csv, PCM5242.kicad_pcb, PCM5242.kicad_sch]
2023-03-31 IOBoard V2 + documentation
    [IOBoard_ATSAMD21.kicad_pcb, IOBoard_ATSAMD21.kicad_sch, pickit4 debug configuration.txt]
2023-03-31 IO Board v2 + documentation
2023-04-03 updated potato os
    [PCM1863.kicad_pcb, PCM1863.kicad_sch]
2023-04-05 generated V2 Gerber/Drill Files
    [IOBoard_ATSAMD21-B_Cu.gbr, IOBoard_ATSAMD21-B_Mask.gbr, IOBoard_ATSAMD21-B_Paste.gbr, IOBoard_ATSAMD21-B_Silkscreen.gbr, IOBoard_ATSAMD21-Edge_Cuts.gbr, IOBoard_ATSAMD21-F_Cu.gbr, IOBoard_ATSAMD21-F_Mask.gbr, IOBoard_ATSAMD21-F_Paste.gbr]
2023-04-07 io board updates
2023-04-07 updated 5242, removed old folder
    I have revamped my PCB design, about 90% to new design (just missing silkscreens)
    [IC_ADS125H01IRHBT.step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]
2023-04-08 Revert "Merge remote-tracking branch 'upstream/main'"
    This reverts commit 91e618c32c18b3f8ce9c65181e2c7ed2aa69dacd, reversing
    changes made to 5f9fe177db78953ec4a0d750e6893e90b3881885.
    [DIX_Board.kicad_pcb, DIX_Board.kicad_sch, IO Board.kicad_pcb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]
2023-04-08 Revert "Revert "Merge remote-tracking branch 'upstream/main'""
    This reverts commit 1d57ca07421005fad3c6f783a10b39dbb3c17bbf.
    [DIX_Board.kicad_pcb, DIX_Board.kicad_sch, IO Board.kicad_pcb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]
2023-04-10 5242 PCB v.3 Update
    Finished V.3. Should have correct footprints, pinouts for analog, good labeling.
    [PCM5242-B_Cu.gbr, PCM5242-B_Mask.gbr, PCM5242-B_Paste.gbr, PCM5242-B_Silkscreen.gbr, PCM5242-Edge_Cuts.gbr, PCM5242-F_Cu.gbr, PCM5242-F_Mask.gbr, PCM5242-F_Paste.gbr]
2023-04-15 adc v6
    [PCM1863-B_Cu.gbr, PCM1863-B_Mask.gbr, PCM1863-B_Paste.gbr, PCM1863-B_Silkscreen.gbr, PCM1863-Edge_Cuts.gbr, PCM1863-F_Cu.gbr, PCM1863-F_Mask.gbr, PCM1863-F_Paste.gbr]
2023-04-16 Transmitter is uploaded
    [Transmitter.kicad_pcb, Transmitter.kicad_sch]
2023-04-16 fixed files
    [Transmitter.kicad_pcb, Transmitter.kicad_sch]
2023-04-16 Version 3 transmitter
    [Transmitter.kicad_pcb, Transmitter.kicad_sch]
2023-04-16 fixed power plane
    [Transmitter.kicad_pcb]
2023-04-17 Version 3.2 of Transmitter. Ready to order
    [Transmitter.kicad_pcb]
2023-04-17 roubd edges
    [Transmitter.kicad_pcb]
2023-04-22 plz work
    [Transmitter.kicad_pcb, Transmitter.kicad_sch]
2023-04-25 restore DAC
    [PCM5242.kicad_pcb, PCM5242.kicad_sch]
2023-04-27 added dimensions to f.fab layer
    [IOBoard_ATSAMD21.kicad_pcb]
2023-04-27 added dimensions to PCB
2023-05-10 mch streamer files
    [PCM1863.kicad_sch, PinMap.xlsx]
2023-05-18 cleaned up'
    [IO Board.kicad_pcb, IO Board.kicad_sch, IOBoard_ATSAMD21.kicad_sch, pickit4 debug configuration.txt]
2023-05-18 added firmware
    [IOBoard_ATSAMD21.kicad_sch, pin_configurations.csv]
2023-05-19 single_ended I/O
    [IOBoard_ATSAMD21.kicad_pcb, IOBoard_ATSAMD21.kicad_sch]
2023-05-19 fix SE add
    [IOBoard_ATSAMD21.kicad_pcb, IOBoard_ATSAMD21.kicad_sch]
2023-05-19 giving up on differential for now
    [IOBoard_ATSAMD21.kicad_pcb, IOBoard_ATSAMD21.kicad_sch]
2023-05-19 adc update to match IO
    [PCM1863.kicad_sch]
2023-05-19 adding libraries
    [APHB1608.step, Arduino_Mega.kicad_pcb, Arduino_Mega.kicad_sch, Arduino_Micro.kicad_pcb, Arduino_Micro.kicad_sch, Arduino_Nano.kicad_pcb, Arduino_Nano.kicad_sch, Arduino_Pro_Mini.kicad_pcb]
2023-05-19 IOBoard v3 WIP
    [IOBoard_ATSAMD21.kicad_pcb, IOBoard_ATSAMD21.kicad_sch]
2023-05-19 manual libraries
    [APHB1608.step, Arduino_Mega.kicad_pcb, Arduino_Mega.kicad_sch, Arduino_Micro.kicad_pcb, Arduino_Micro.kicad_sch, Arduino_Nano.kicad_pcb, Arduino_Nano.kicad_sch, Arduino_Pro_Mini.kicad_pcb]
2023-05-21 IO Board v3
    [IOBoard_ATSAMD21.kicad_pcb, IOBoard_ATSAMD21.kicad_sch]
2023-05-22 changing io
    [IOBoard_ATSAMD21.kicad_pcb]
2023-05-22 adc images
2023-05-22 added IO Board dimensions
    [IOBoard_ATSAMD21-B_Cu.gbr, IOBoard_ATSAMD21-B_Mask.gbr, IOBoard_ATSAMD21-B_Paste.gbr, IOBoard_ATSAMD21-B_Silkscreen.gbr, IOBoard_ATSAMD21-Edge_Cuts.gbr, IOBoard_ATSAMD21-F_Cu.gbr, IOBoard_ATSAMD21-F_Mask.gbr, IOBoard_ATSAMD21-F_Paste.gbr]
2023-05-27 updated README: added instructions for addressing LEDs
2023-06-08 fixed bitwise operations
    [IOBoard_ATSAMD21.csv, PCM1863.csv, PCM1863.kicad_sch]
